woutput/regenboogpiano/Mechanica/Klavier/Grove layout klavier.png

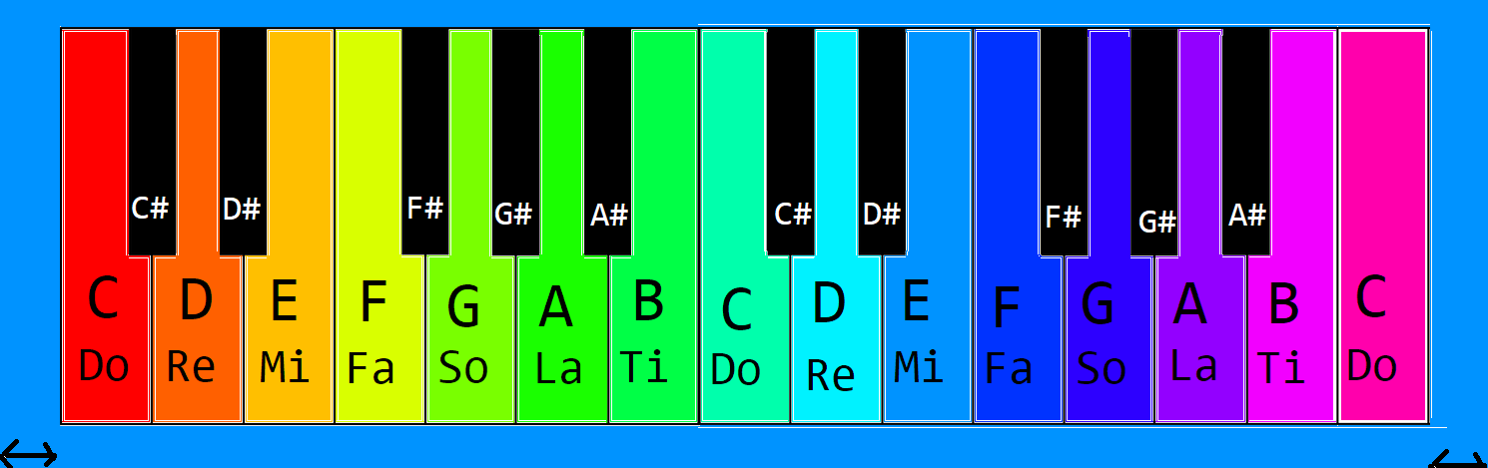
Mechanica/Klavier/Grove layout klavier.png
