woutput/regenboogpiano/Mechanica/Klavier/Klavier volgens boomwhackers.png

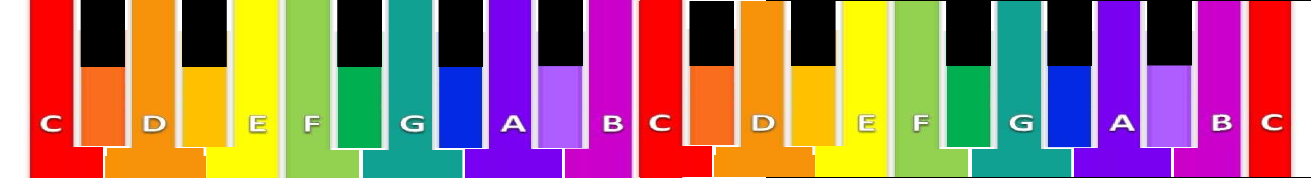
Mechanica/Klavier/Klavier volgens boomwhackers.png
