woutput/regenboogpiano/Oud/Elektronisch wandspeelbord - voorstel.docx

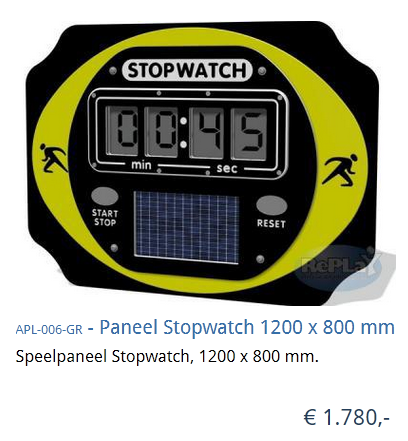
[picture p3: figure]
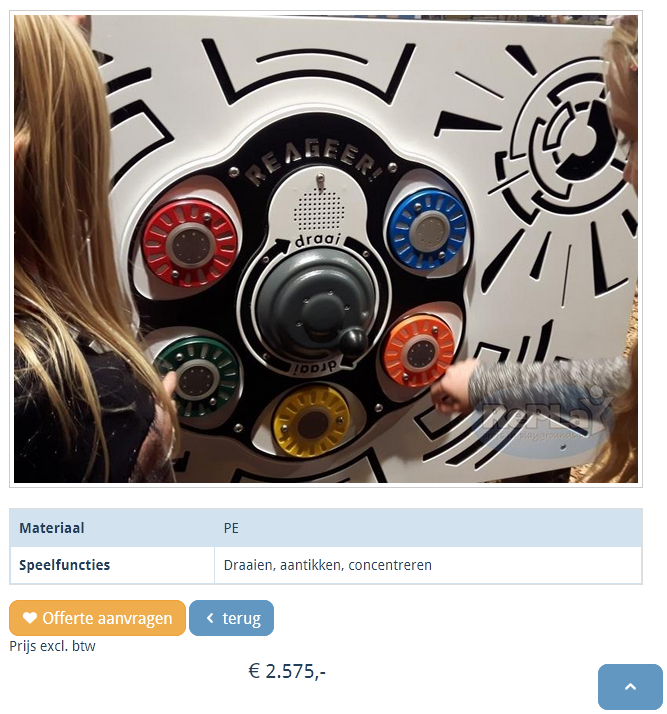
[picture p4: figure]

Bijvoorbeeld thema Regenboogschool

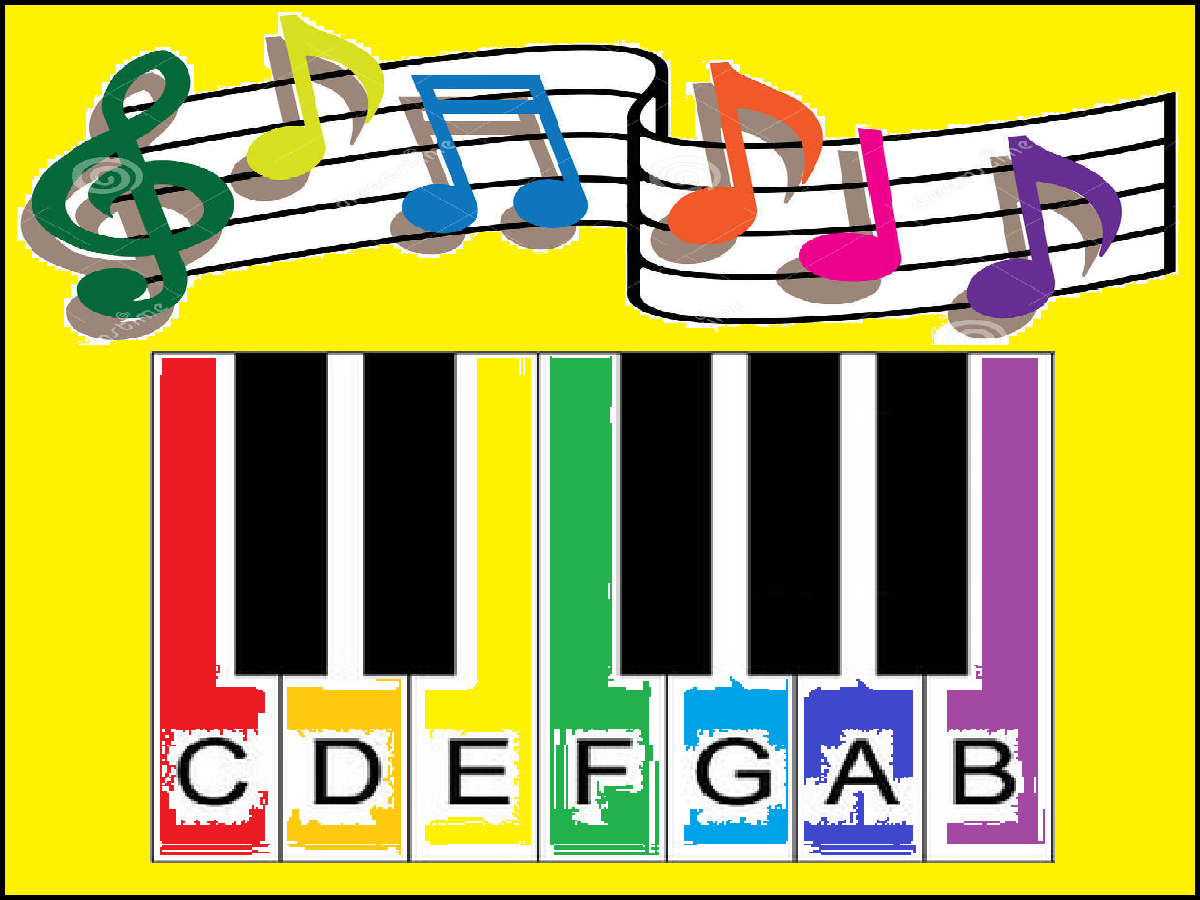
[picture p5: figure]

A. Kinderen spelen zelf op de piano
B. De lampjes laten de juiste volgorde zien, de kinderen spelen een liedje
C. Muziek speelt, de kinderen spelen mee op de piano (zoals Guitar Hero op PlayStation)
D. De computer speelt een liedje, begint met de eerste noot, steeds één noot langer, de kinderen spelen het zo lang mogelijk na (“Simon says”)
E. …

Veilig, robuust, onderhoudsvriendelijk, leerzaam, leuk, …

Schatting kosten

- Mechanica ~ €250
- Elektronica ~ €250
- Totaal ~ €500
