woutput/regenboogpiano/Elektronica/Facturen/E.pdf

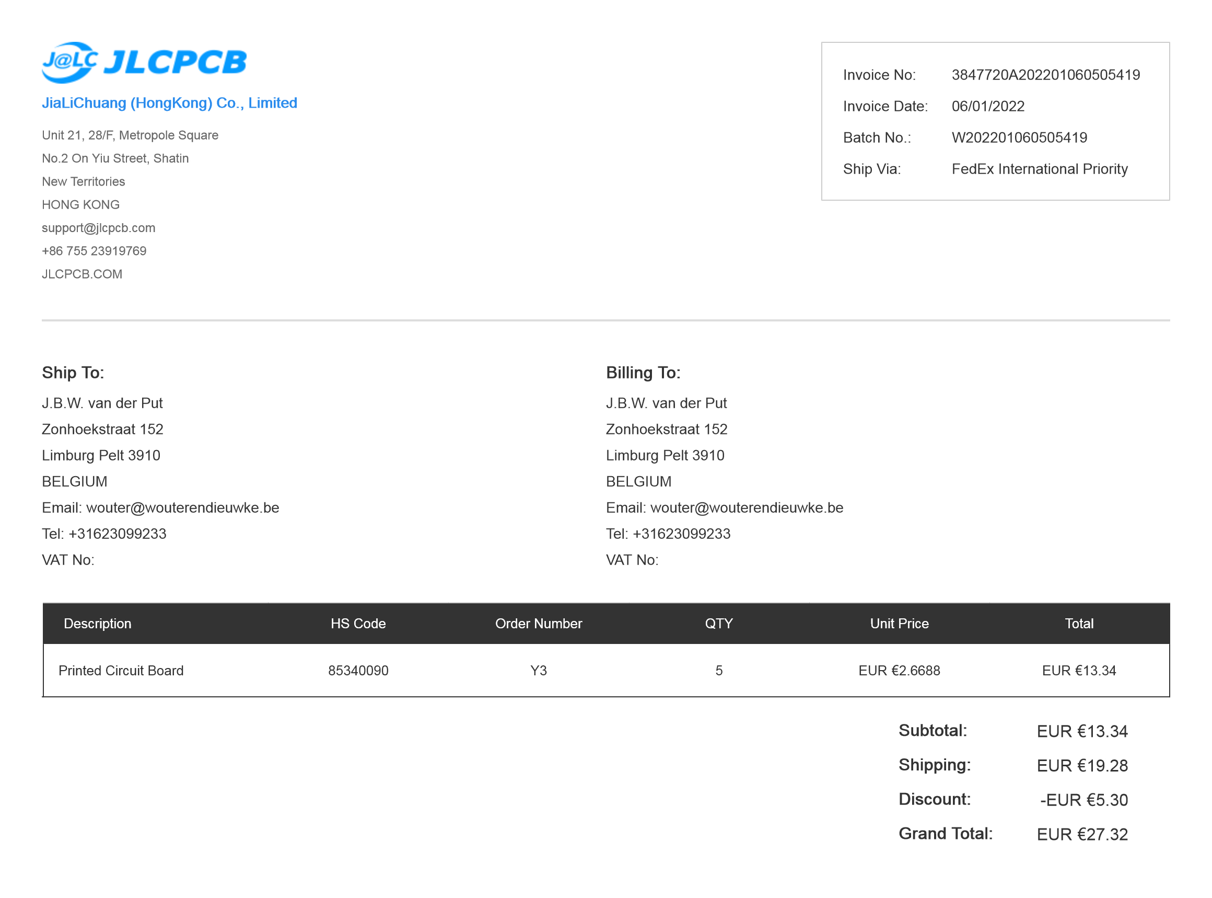
[picture p6: figure]
