woutput/regenboogpiano/Elektronica/Facturen/F.pdf

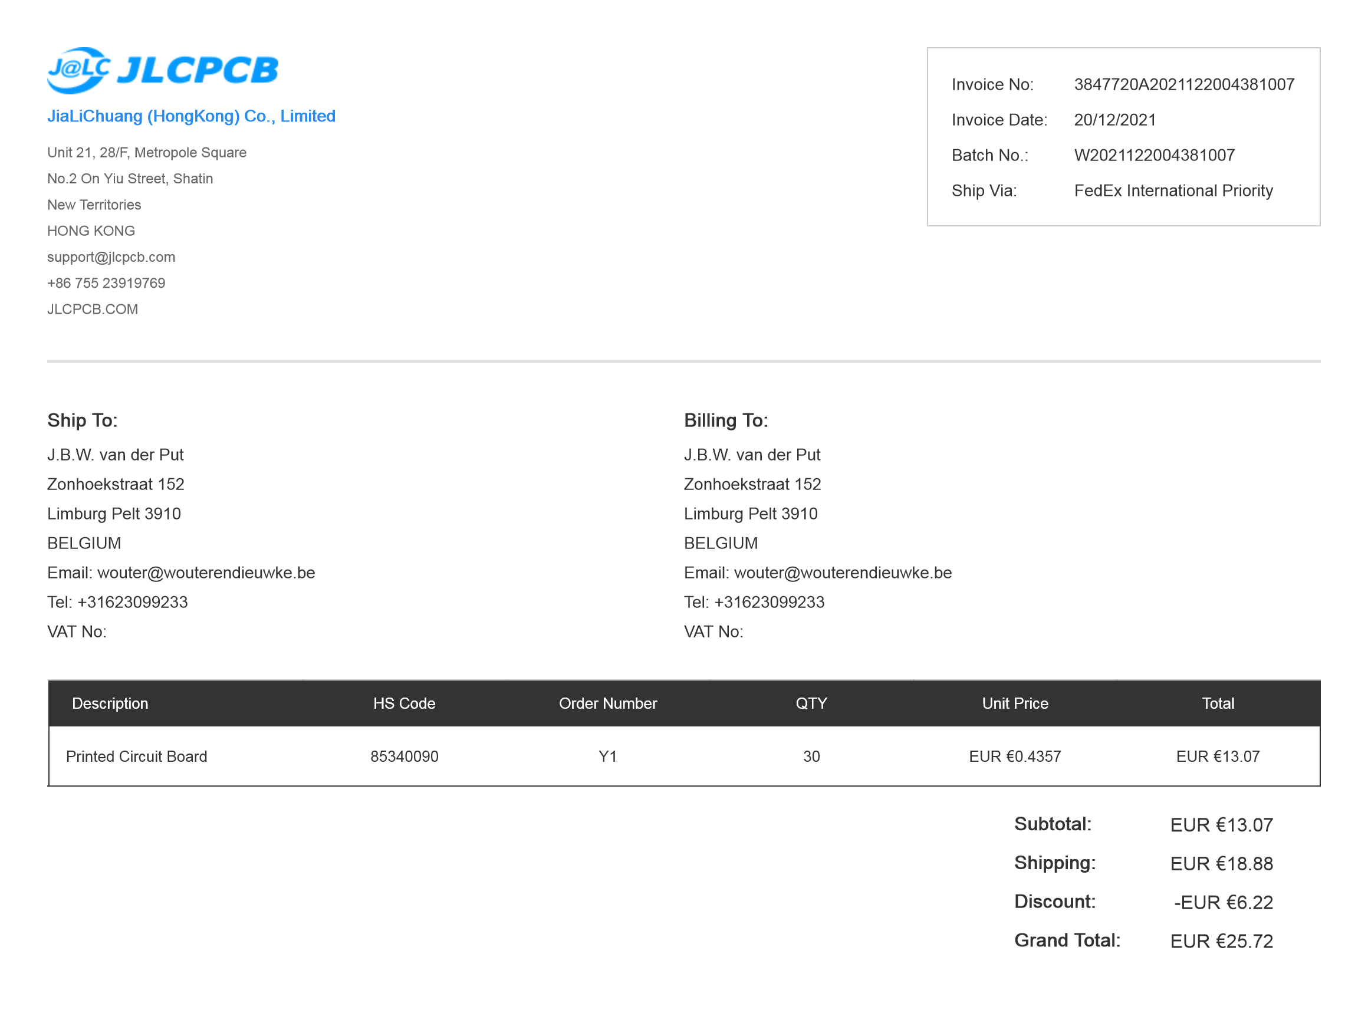
[picture p7: figure]
