woutput/regenboogpiano/Mechanica/Klavier/12 kleuren.xlsx

# | Hue | R | G | B | Noot | C[%] | M[%] | Y[%] | K[%] | Naam
0 | 0 | 255 | 0 | 0 | C | 0 | 100 | 100 | 0 | ROOD
1 | 14 | 255 | 61 | 0 | C# (zwart) | 0 | 76 | 100 | 0 | ROOD-ORANJE
2 | 28 | 255 | 120 | 0 | D | 0 | 53 | 100 | 0 | ORANJE
3 | 44 | 255 | 186 | 0 | D# (zwart) | 0 | 27 | 100 | 0 | ORANJE-GEEL
4 | 60 | 255 | 255 | 0 | E | 0 | 0 | 100 | 0 | GEEL
5 | 90 | 128 | 255 | 0 | F | 50 | 0 | 100 | 0 | GEEL-GROEN
6 | 114 | 26 | 255 | 0 | F# (zwart) | 90 | 0 | 100 | 0 | GROEN
7 | 146 | 24 | 237 | 116 | G | 91 | 7 | 54 | 0 | GROEN-BLAUW
8 | 233 | 28 | 56 | 255 | G# (zwart) | 89 | 78 | 0 | 0 | BLAUW
9 | 251 | 84 | 46 | 255 | A | 67 | 82 | 0 | 0 | BLAUWPAARS
10 | 260 | 130 | 69 | 255 | A# (zwart) | 49 | 73 | 0 | 0 | PAARS
11 | 280 | 179 | 23 | 255 | B | 30 | 91 | 0 | 0 | PAARSROOD
