woutput/regenboogpiano/Mechanica/Klavier/cmyk.xlsx

 | ROOD | ROOD-ORANJE | ORANJE | ORANJE-GEEL | GEEL | GEEL-GROEN | GROEN | GROEN-BLAUW | BLAUW | BLAUWPAARS | PAARS | PAARSROOD
 | C | C# | D | D# | E | F | F# | G | G# | A | A# | B
C | 0 | 0 | 0 | 0 | 0 | 50 | 90 | 91 | 89 | 67 | 49 | 30
M | 100 | 76 | 53 | 27 | 0 | 0 | 0 | 7 | 78 | 82 | 73 | 91
Y | 100 | 100 | 100 | 100 | 100 | 100 | 100 | 54 | 0 | 0 | 0 | 0
K | 0 | 0 | 0 | 0 | 0 | 0 | 0 | 0 | 0 | 0 | 0 | 0
