woutput/regenboogpiano/Detail toets.png

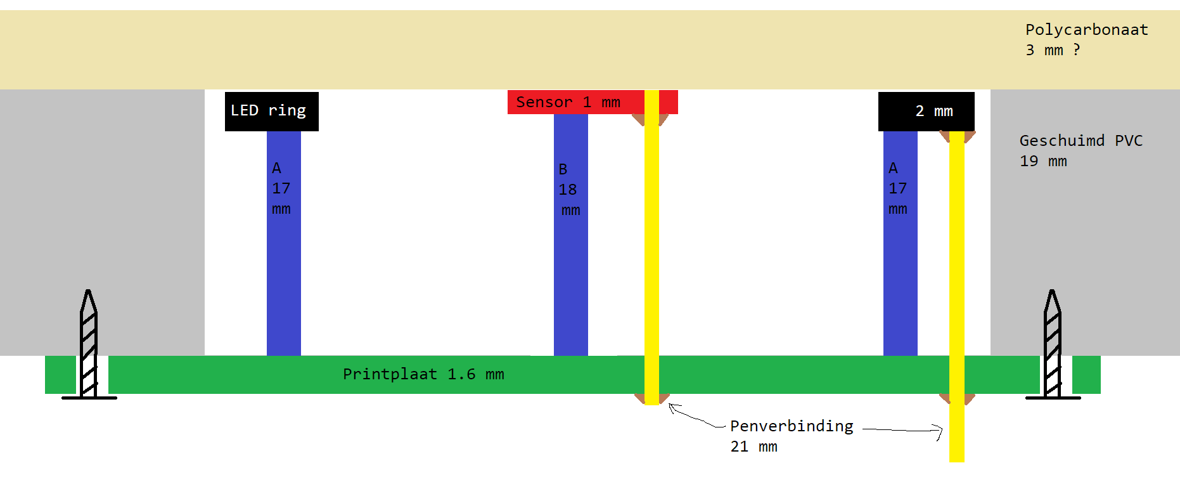
Detail toets.png
