woutput/regenboogpiano/Elektronica/KiCad projecten/Toetsmodule/Schema.png

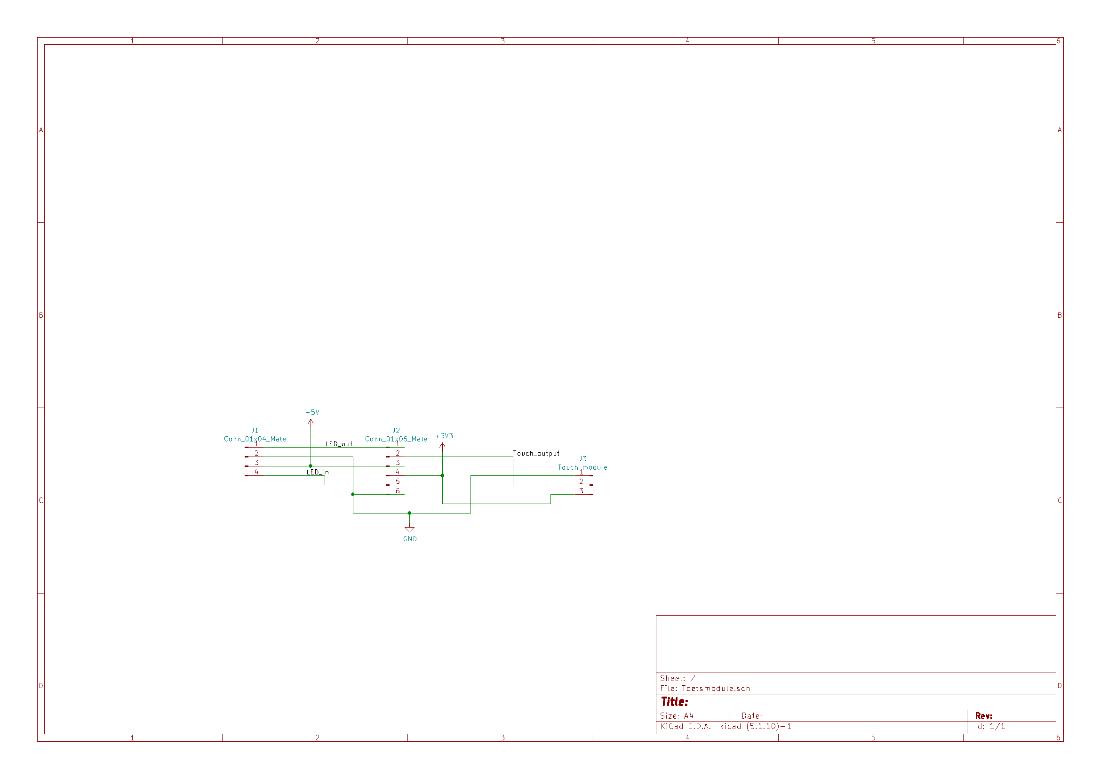
Elektronica/KiCad projecten/Toetsmodule/Schema.png
