woutput/regenboogpiano/Elektronica/Overzicht elektrisch schema.png

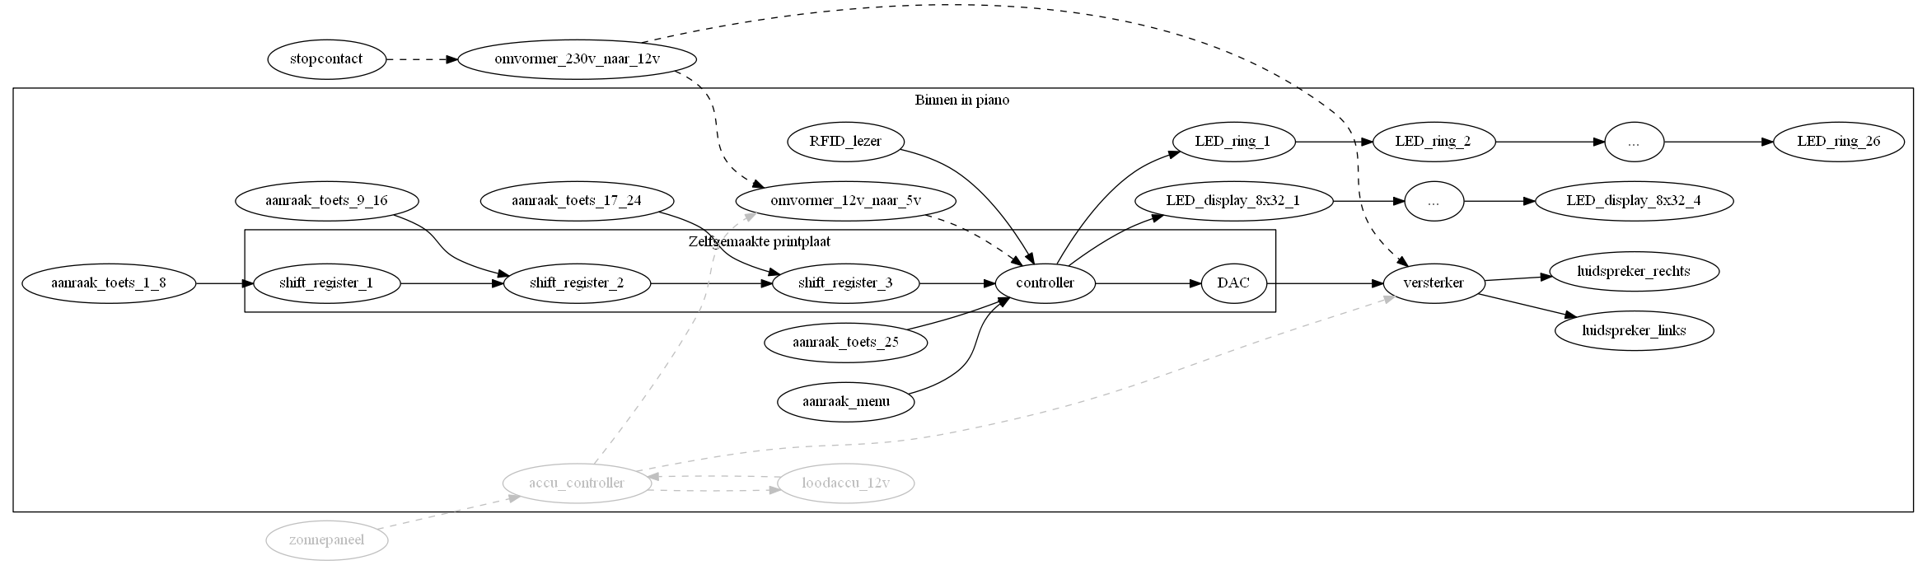
Elektronica/Overzicht elektrisch schema.png
