woutput/regenboogpiano/Mechanica/3D-model/Regenboogpiano.png

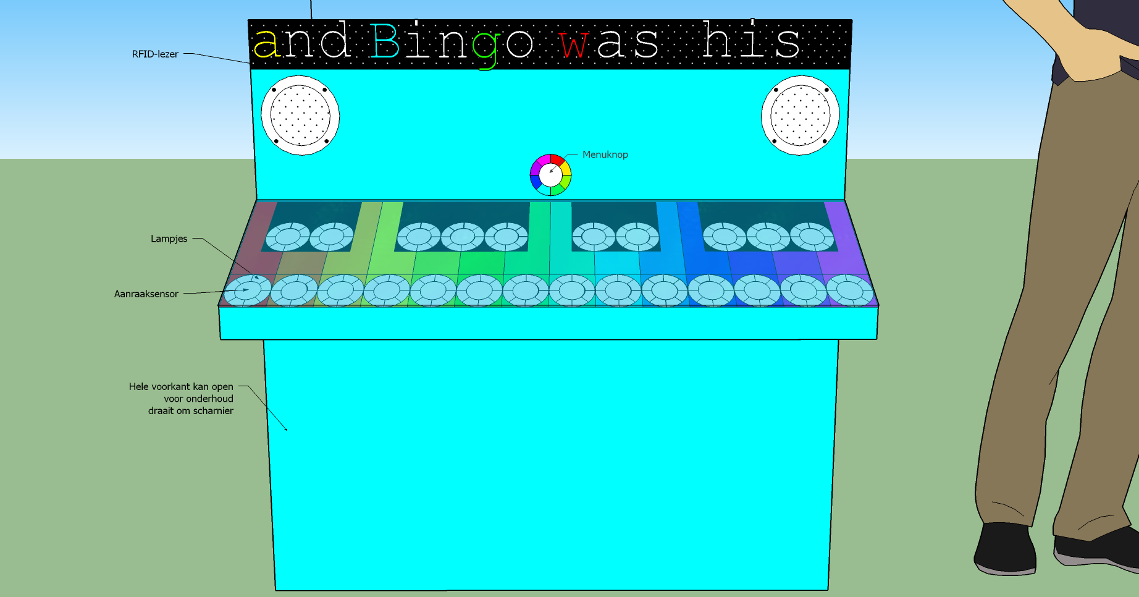
Mechanica/3D-model/Regenboogpiano.png
