woutput/regenboogpiano/Mechanica/Klavier/index.jpg

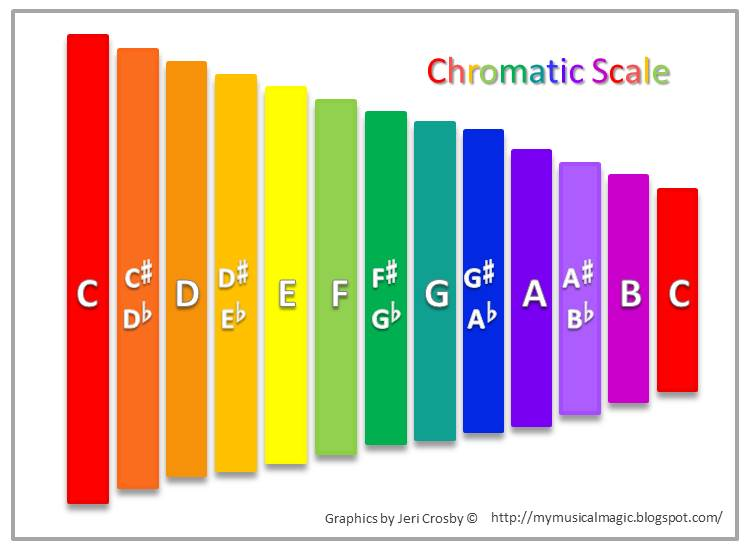
Mechanica/Klavier/index.jpg
