woutput/regenboogpiano/Mechanica/Klavier/Klavier detail.png

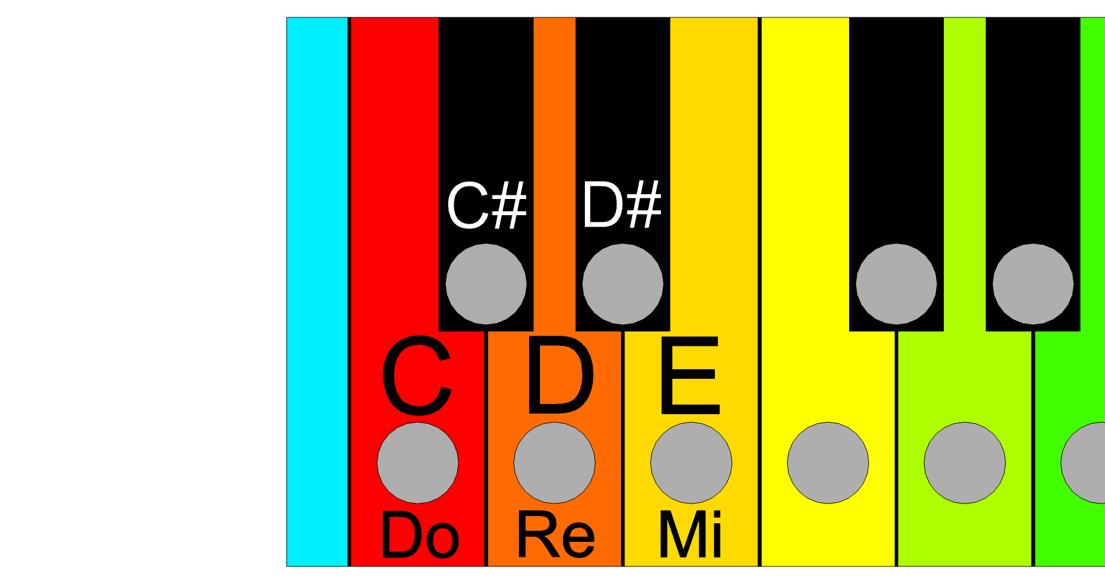
Mechanica/Klavier/Klavier detail.png
