woutput/regenboogpiano/Mechanica/Klavier/Klavier helemaal.png

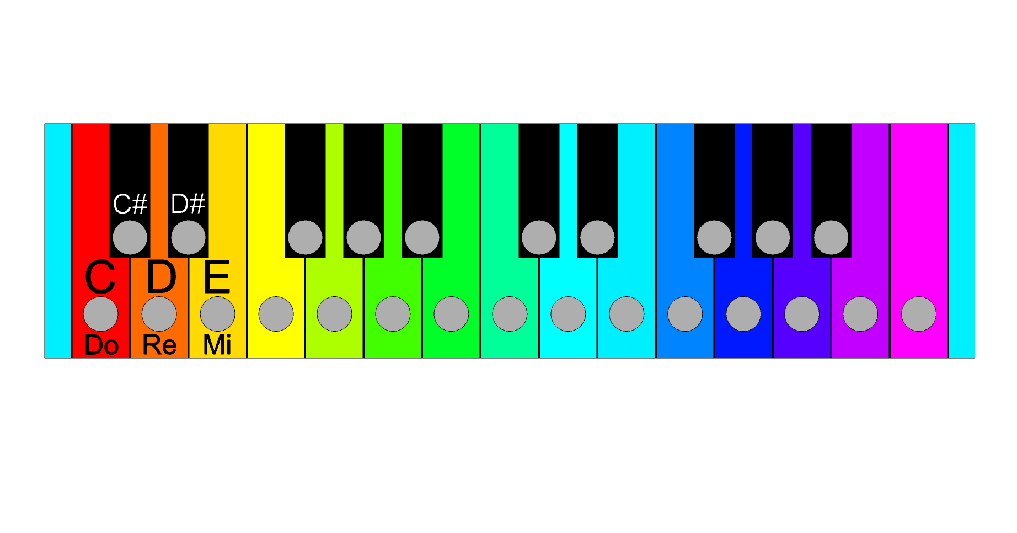
Mechanica/Klavier/Klavier helemaal.png
