woutput/regenboogpiano/Mechanica/Klavier/Kleuren vs boomwhackers.png

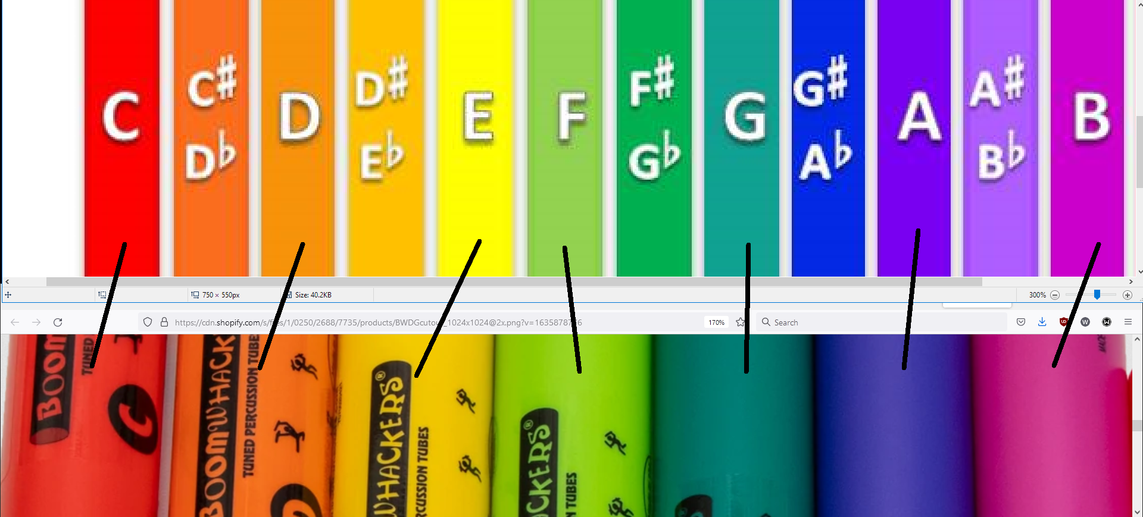
Mechanica/Klavier/Kleuren vs boomwhackers.png
