woutput/regenboogpiano/Oud/Kinderen opmeten/Grond - Hoofd.png

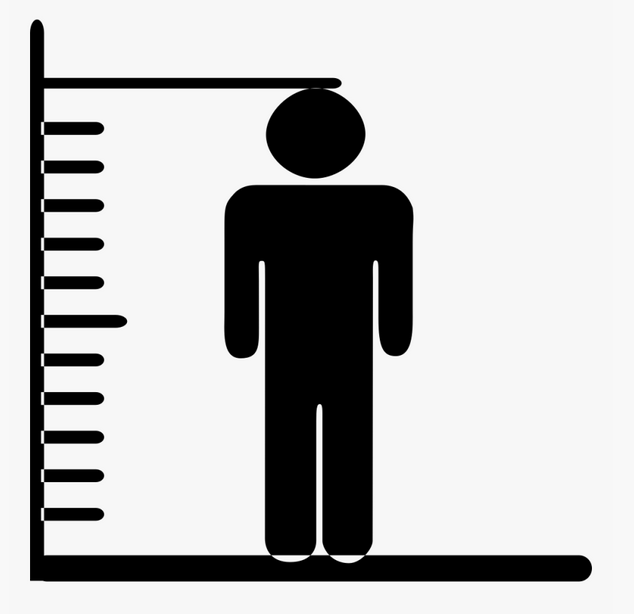
Oud/Kinderen opmeten/Grond - Hoofd.png
