woutput/regenboogpiano/Oud/Kinderen opmeten/Puntje middelvinger links - Puntje middelvinger rechts.png

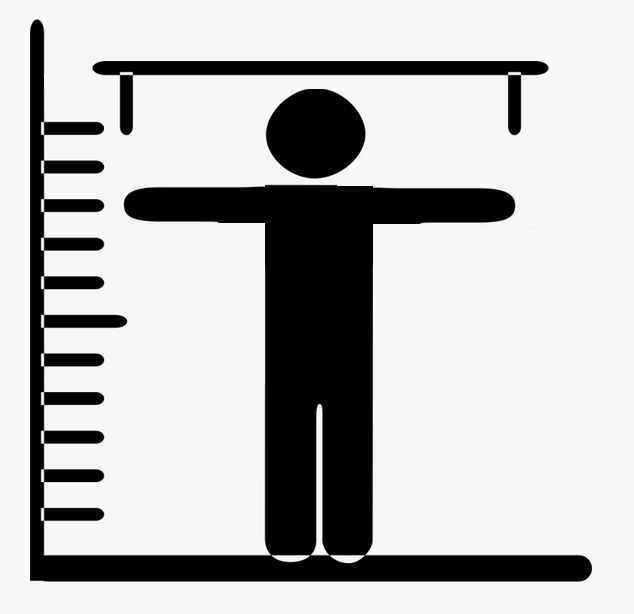
Oud/Kinderen opmeten/Puntje middelvinger links - Puntje middelvinger rechts.png
