woutput/regenboogpiano/Oud/Vergelijking afmetingen.png

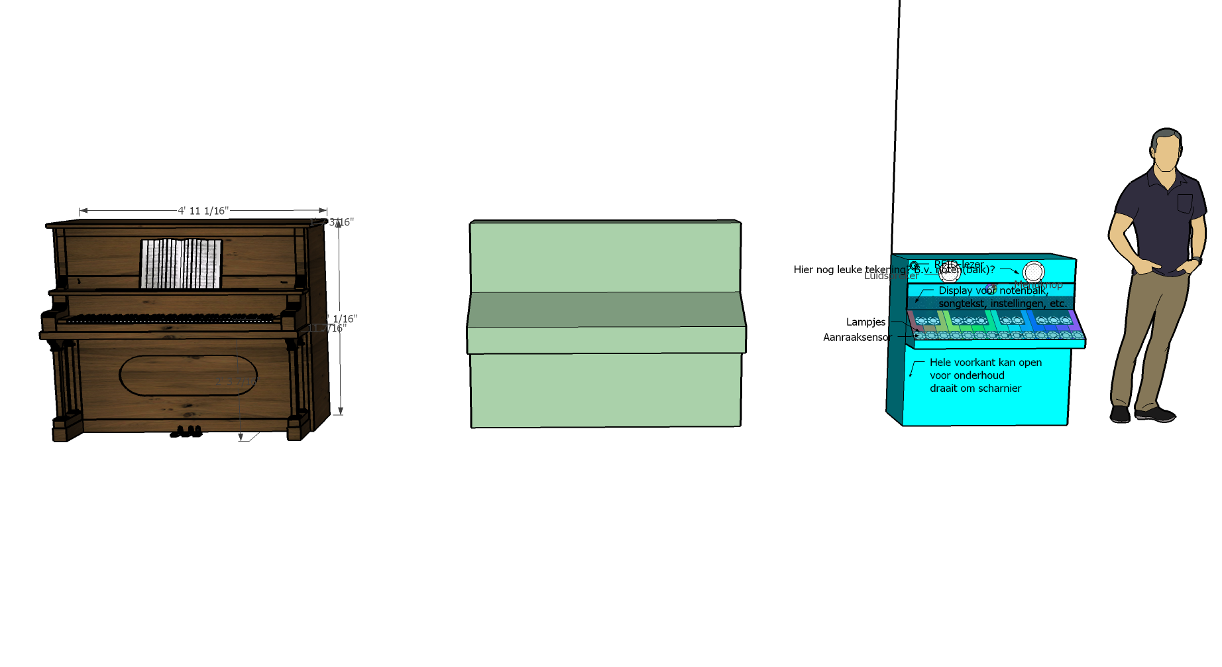
Oud/Vergelijking afmetingen.png
