woutput/regenboogpiano/Oud/Verhoudingen.png

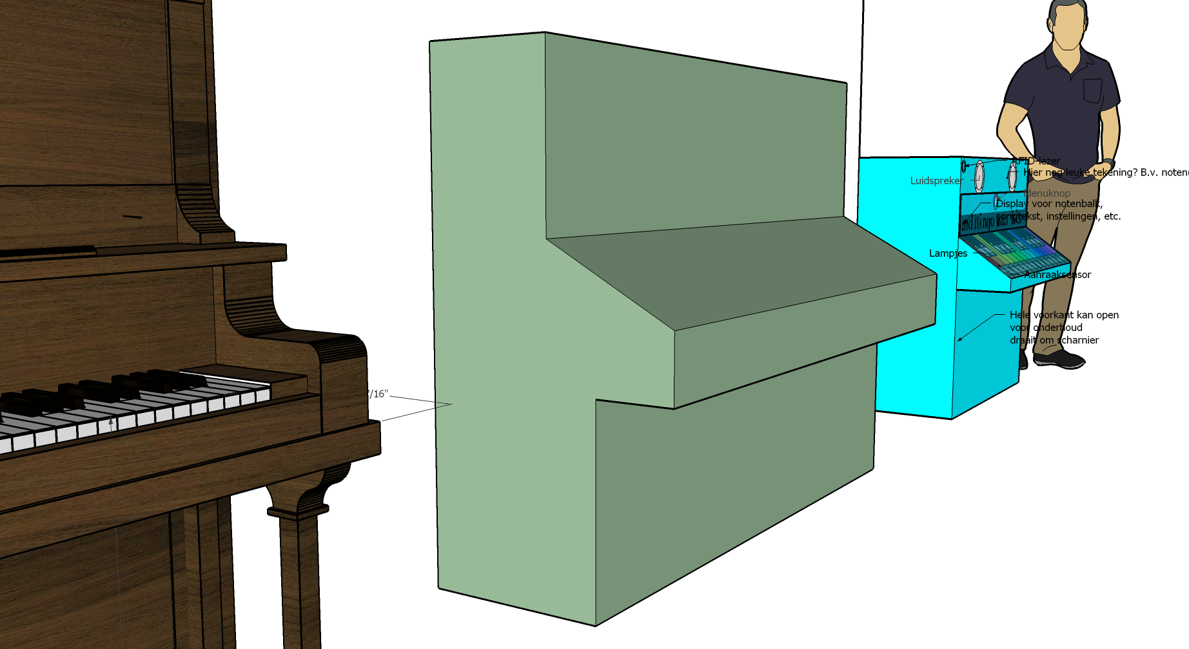
Oud/Verhoudingen.png
