woutput/regenboogpiano/Welke noten in het klavier.png

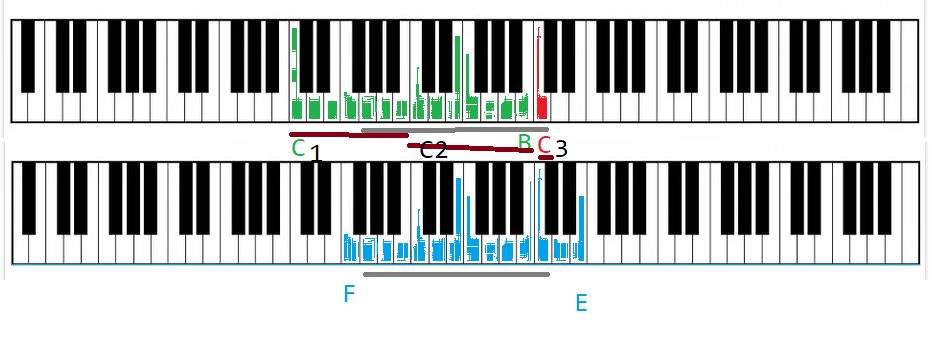
Welke noten in het klavier.png
