woutput/regenboogpiano/Onderdelen en kosten.xlsx

Aantal | Beschrijving | Winkel | Prijs per stuk | Subtotaal | Factuur | Gekocht | Betaald | Reserve | Opmerking
25 | LED-ring, 12 LEDs | Amazon | €4.00 | €100.00 | A | 30 | €59.94 | 5
 | LED-ring, 12 LEDs | AliExpress |  |  | B | 5 | €7.27 | 5
1 | Zonnepaneel 18 V, 30 W + controller 12 V, 10 A? | AliExpress | €45.00 | €45.00 |  | 0 | €0.00 | 0 | Voor de toekomst?
3 | LED-display 8x32 | AliExpress | €14.00 | €42.00 | C | 3 | €31.70 | 0
 | LED-display 8x32 | AliExpress |  |  | D | 3 | €31.73 | 2
1 | Zelfgemaakte printplaat moederbord | JLCPCB | €40.00 | €40.00 | E | 5 | €27.69 | 4 | Prijs inclusief wisselkosten
0 | Zelfgemaakte printplaat toetsmodule | JLCPCB | €0.00 | €0.00 | F | 30 | €25.94 | 5 | Prijs inclusief wisselkosten
1 | microSD, industr., SLC, 8 GB | RS-online | €35.00 | €35.00 |  | 0 | €0.00 | 0 | Niet nodig
1 | Loodaccu 12V, AGM, 12 Ah | NKON | €30.00 | €30.00 |  | 0 | €0.00 | 0 | Voor de toekomst?
0 | Voeding 12 V, 100 W | Tinytronics | €0.00 | €0.00 | G | 2 | €44.48 | 1 | In plaats van zonnepaneel/accu
1 | Omvormer 12V>5V, 20A | AliExpress | €30.00 | €30.00 | H | 2 | €34.48 | 1
2 | Luidspreker, waterproof | AliExpress | €12.50 | €25.00 | I | 2 | €17.75 | 0
 | Luidspreker, waterproof | AliExpress |  |  | J | 1 | €9.73 | 1
1 | Bedrading, connectors, e.d. | AliExpress | €25.00 | €25.00 | K |  | €8.63 |  | PCB terminal blocks
 | Bedrading, connectors, e.d. | Reichelt |  |  | L |  | €25.71 |  | Zekeringen, zekeringhouders en bezuining voor voeding
 | Bedrading, connectors, e.d. | AliExpress |  |  | R |  | €2.60 |  | Lange pinnen 2.54 mm
 | Bedrading, connectors, e.d. | AliExpress |  |  | S |  | €28.13 |  | Bandkabel, kabelconnectors en PCB-connectors
 | Bedrading, connectors, e.d. | allekabels.nl |  |  | V | 2 | €22.93 |  | Plastic-spray
1 | Controller, ESP32, T-Display | AliExpress | €15.00 | €15.00 | M | 1 | €13.16 | 0
 | Controller, ESP32, T-Display | Tinytronics |  |  | T | 1 | €13.48 | 1
1 | Versterker (klasse D) | Tinytronics | €9.00 | €9.00 | G | 2 | €22.48 | 1
25 | Aanraaksensor | AliExpress | €0.30 | €7.50 | N | 50 | €4.92 | 25
2 | DAC | AliExpress | €2.50 | €5.00 | O | 1 | €14.52 | 0 | Losse DAC is ondertussen veel duurder geworden
 | DAC | AliExpress |  |  | U | 1 | €3.48 | 1
1 | RFID-lezer | AliExpress | €3.00 | €3.00 | P | 2 | €2.78 | 1
1 | MicroSD card expansion board | AliExpress | €2.00 | €2.00 |  | 0 | €0.00 | 0 | Niet nodig
3 | Shift register 74HC165 of 74HC166 | AliExpress | €0.50 | €1.50 | Q | 5 | €5.58 | 2
1 | Onvoorzien 10% | ? | €41.50 | €41.50 |  | 0 | €0.00
 | Totaal elektronica |  |  | €456.50 |  |  | €459.10
2 | Geschuimd PVC, 10/19 mm [m2] | Zwartopwit | €90.00 | €180.00 |  |  | €650.00 |  | Geschuimd PVC i.p.v. Trespa
20 | Frame [m] | Walth? | €10.00 | €200.00 |  |  | €0.00 |  | Staal i.p.v. Hout
5 | Volkern/Trespa | Kunststofplaten | €60.00 | €300.00 |  | 0 | €0.00 |  | Geschuimd PVC i.p.v. Trespa
1 | Polycarbonaat, 3 mm [m2] | Kunststofplaten | €76.00 | €76.00 |  | 0 | €0.00
1 | IJzerwaren | ? | €50.00 | €50.00
1 | Onvoorzien 10% | ? | €80.60 | €80.60 |  |  |  |  | Wielen
 | Totaal mechanica |  |  | €886.60 |  |  | €650.00
 | Totaal |  | Begroot 10 nov | €1343.10 |  |  | €1109.10 |  | Werkelijk uitgegeven
