woutput/regenboogpiano/Oud/Kunststof.xlsx

Materiaal | Kleuren | Dikte [mm] | X [mm] | Y [mm] | Opp. [m2] | Plaat | Verzenden | Totaal/m2 | Speciaal | Speciaal | URL
PVC-hardschuim | 7 | 3 | 1000 | 1000 | 1.00 | €21.00 | €7.95 | €28.95 |  |  | Link (https://www.hornbach.nl/shop/GUTTAGLIss-Hobbycolor-kunststof-plaat-rood-500-x-250-x-3-0-mm/3887974/artikel.html)
Plexiglas | Rood/Groen/Blauw/Oranje/Wit/Grijs | 3 | 1000 | 1000 | 1.00 | €40.00 | €4.95 | €44.95 | Ophalen/bezorgen NL | Lichtdoorlatend | Link (https://www.hornbach.nl/shop/GUTTAGLIss-Acrylglas-Acrylcolor-glad-rood-250-x-500-x-3-0-mm/8055672/artikel.html)
Plexiglas | Rood/Groen/Blauw/Geel/Wit/Zwart | 3 | 1000 | 1000 | 1.00 | €63.55 | €42.29 | €105.8395 | Op maat meerkost |  | Link (https://kunststofplaten.be/product/opaalrood-plexiglas-3-mm/)
Plexiglas | Veel kleuren | 8 | 1000 | 1000 | 1.00 |  |  | €181.38 | Op maat |  | Link
Plexiglas | 13 | 8 | 300 | 200 | 0.06 |  |  | €30.79 |  |  | Link (https://shop.letterplex.nl/contents/nl/p816.html)
Geschuimd PVC == Forex | Geprint op wit | 10 | 1000 | 1000 | 1.00 | €65.00 | €11.98 | €76.979 | Op maat |  | Link (https://www.zwartopwit.be/shop/borden-panelen/schuim-pvc-10-mm/rechte-hoeken/quality/schuim-pvc-10-mm-premium-recto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)
Schuim PS | Geprint op wit | 10 | 1000 | 1000 | 1.00 | €66.75 | €11.98 | €78.729 | Op maat |  | Link (https://www.zwartopwit.be/shop/borden-panelen/schuim-ps-10-mm/rechte-hoeken/quality/smart-x-10-mm-premium-recto)
Geschuimd PVC == Forex | 9 | 3 | 400 | 300 | 0.12 | €5.45 | €12.04 | €145.7041667 |  |  | Link (https://shop.letterplex.nl/contents/nl/p388.html)
HPL == Trespa | 15 | 6 | 1000 | 1000 | 1.00 | €92.65 | €48.39 | €141.0376 | Op maat |  | Link (https://kunststofplatenshop.nl/hpl-plaat/kleur-structuur/)
 |  |  |  |  | 0.00 |  |  | #DIV/0! |  |  | Link
 |  |  |  |  | 0.00 |  |  | #DIV/0! |  |  | Link
 |  |  |  |  | 0.00 |  |  | #DIV/0! |  |  | Link
 |  |  |  |  | 0.00 |  |  | #DIV/0! |  |  | Link
 |  |  |  |  | 0.00 |  |  | #DIV/0! |  |  | Link
 |  |  |  |  | 0.00 |  |  | #DIV/0! |  |  | Link
 |  |  |  |  | 0.00 |  |  | #DIV/0! |  |  | Link
 |  |  |  |  | 0.00 |  |  | #DIV/0! |  |  | Link
 |  |  |  |  | 0.00 |  |  | #DIV/0! |  |  | Link
