woutput/regenboogpiano/(list of files, cad)

Other CAD files:
Mechanica/3D-model/Regenboogpiano.skp
Mechanica/3D-model/piano.skp
Mechanica/3D-model/piano1.skp
Mechanica/Klavier/Klavier.skp
