woutput/regenboogpiano/Software/diagram.pdf

## REGENBOOGPIANO DIAGRAM

V. 2022-01-14

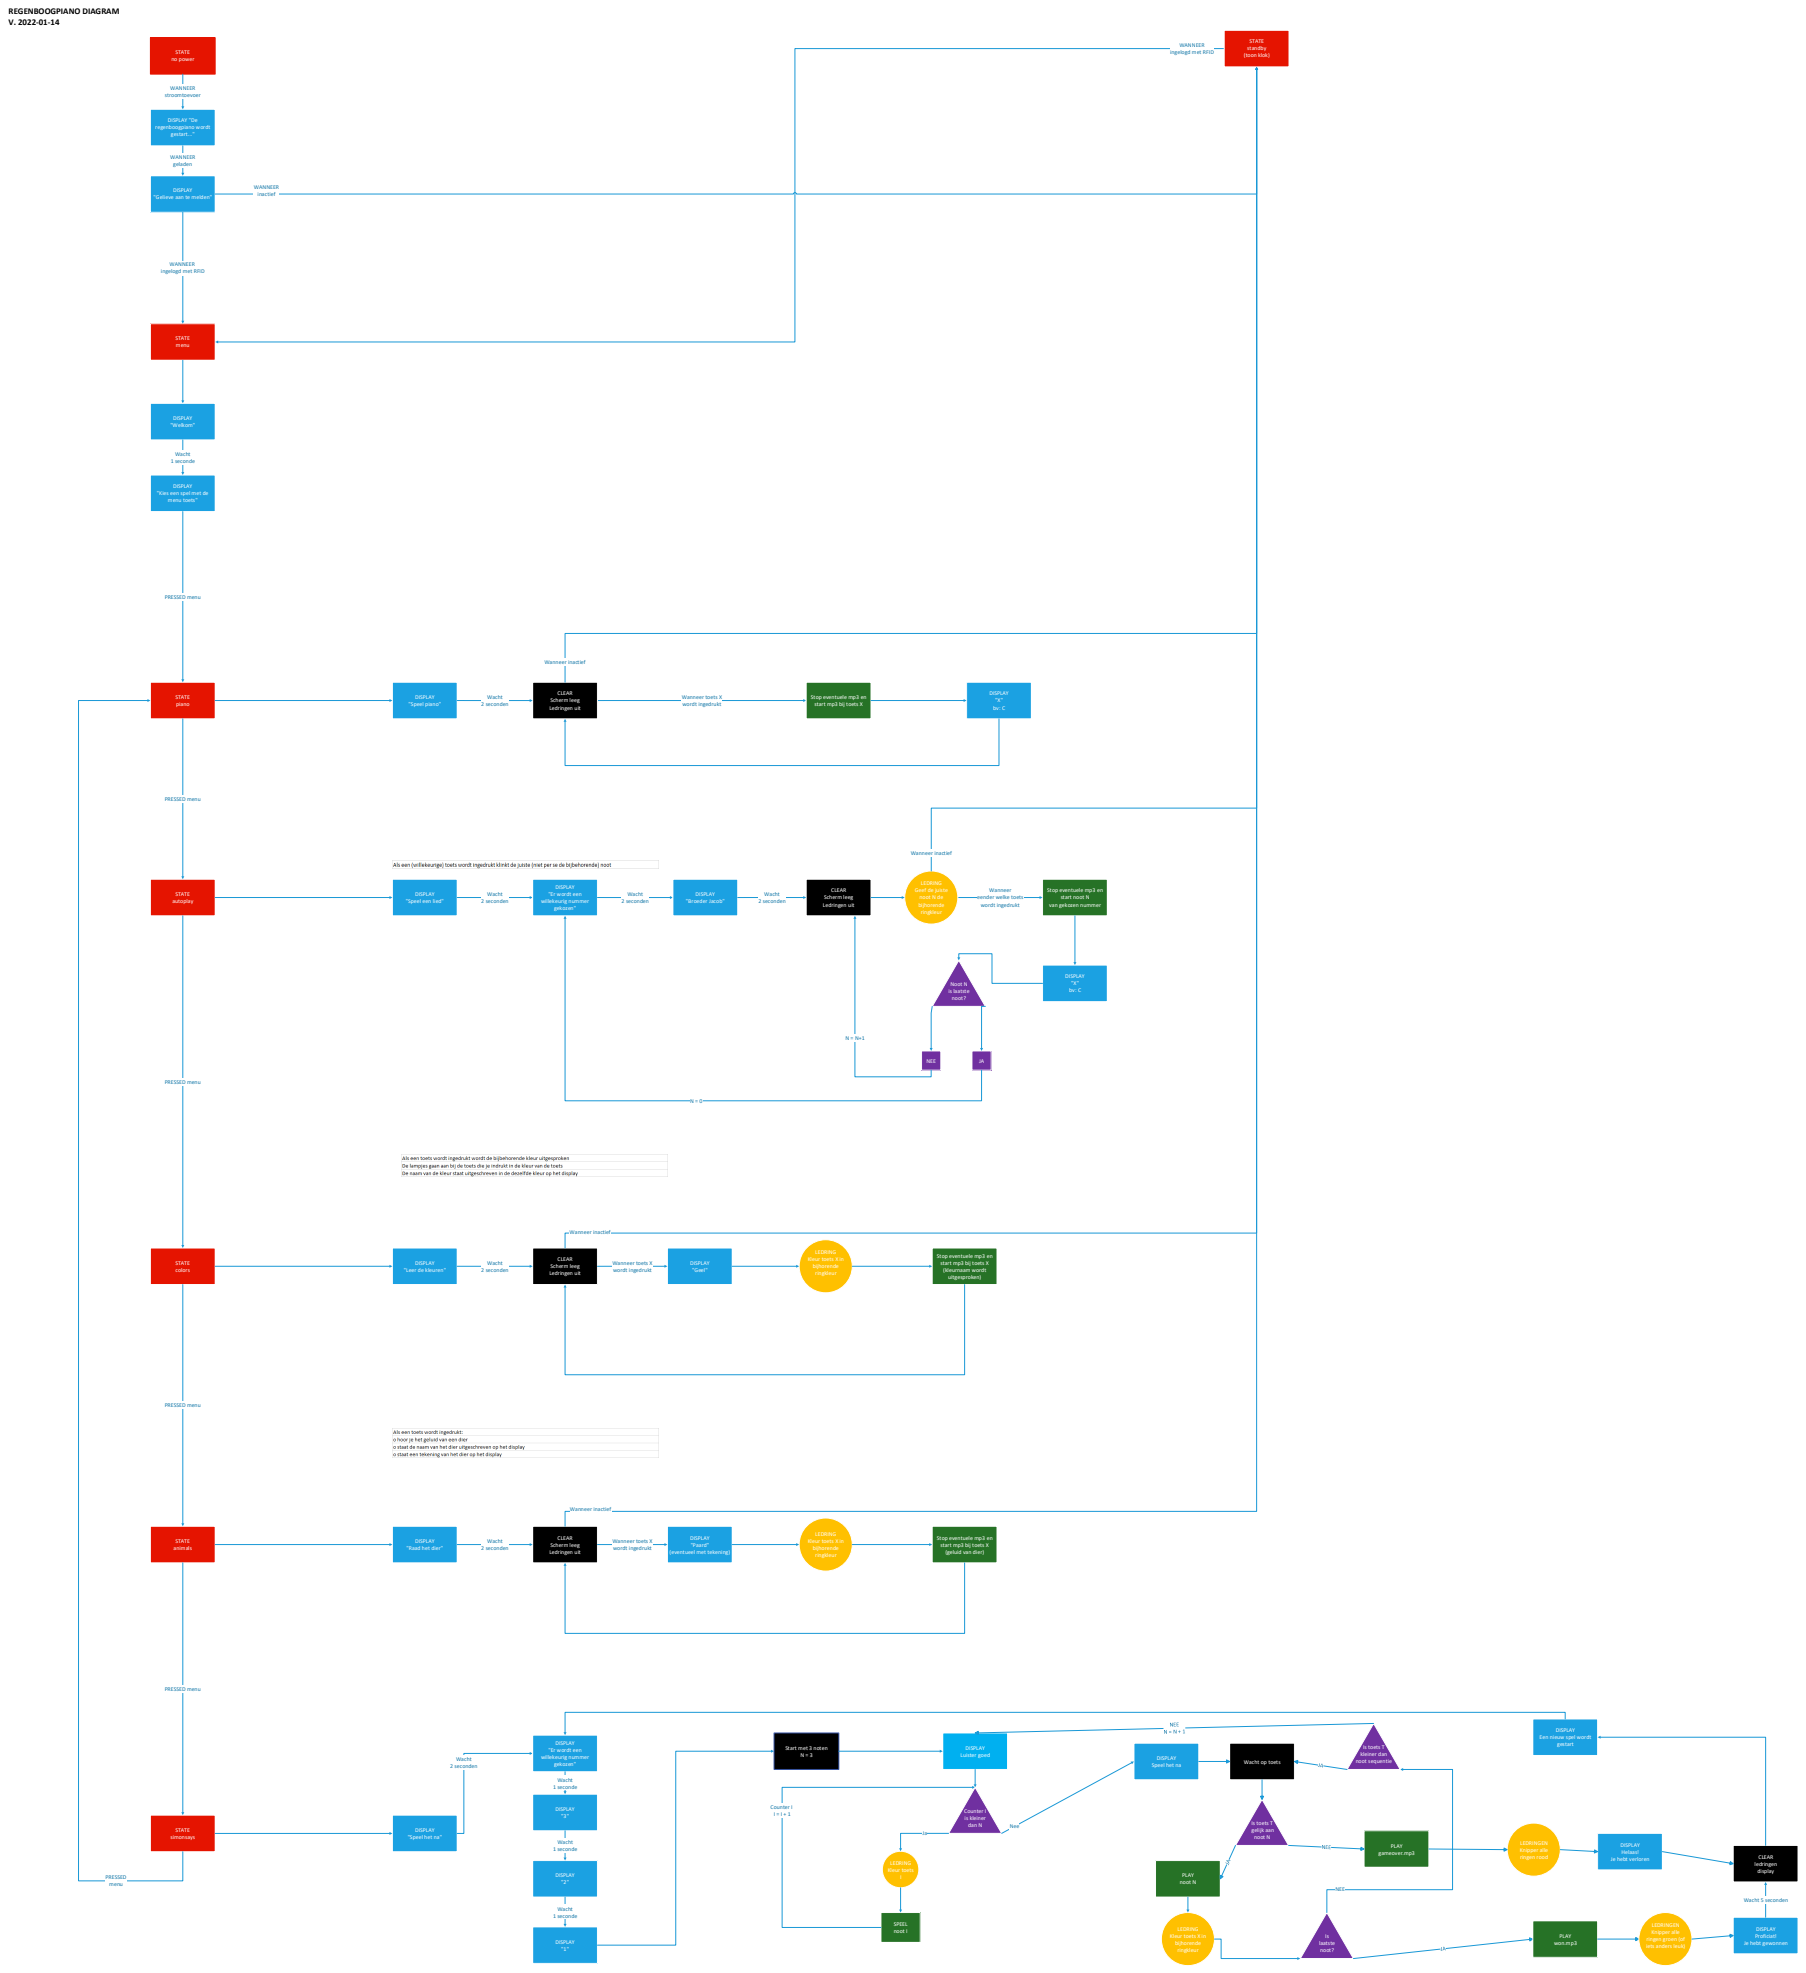
[picture p21: page 1]
STATE no power; DISPLAY; DISPLAY "De regenboogpiano wordt gestart..."; WANNEER stroomtoevoer; WANNEER geladen; WANNEER inactief; STATE menu; STATE standby (toon klok); DISPLAY "Speel piano"; STATE piano; PRESSED menu; STATE autoplay; STATE colors; STATE animals; STATE simonsays; Wanneer toets X wordt ingedrukt; CLEAR Scherm leeg Ledringen uit; Wacht 2 seconden; DISPLAY "X" bv: C; DISPLAY "Broeder Jacob"; Noot N is laatste noot?; NEE; DISPLAY "Geel"; DISPLAY "Paard"; DISPLAY "3"; DISPLAY "2"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

WANNEER
ingelogd met RFID

"Gelieve aan te melden"

DISPLAY
"Kies een spel met de
menu toets"

Stop eventuele mp3 en
start mp3 bij toets X

LEDRING
Geef de juiste
noot N de
bijhorende
ringkleur

"Er wordt een
willekeurig nummer
gekozen"

Wanneer
eender welke toets
wordt ingedrukt

start noot N
van gekozen nummer

"Speel een lied"

Kleur toets X in

(kleurnaam wordt
uitgesproken)

"Leer de kleuren"

(geluid van dier)

"Raad het dier"

(eventueel met tekening)

Een nieuw spel wordt
gestart

Start met 3 noten

Speel het na

Wacht op toets

"Speel het na"

Helaas!
Je hebt verloren

LEDRINGEN
Knipper alle
ringen groen (of
iets anders leuk)

Proficiat!
Je hebt gewonnen
