woutput/regenboogpiano/Mechanica/Bestelling PVC-schuim-platen/1. voetplaat.pdf

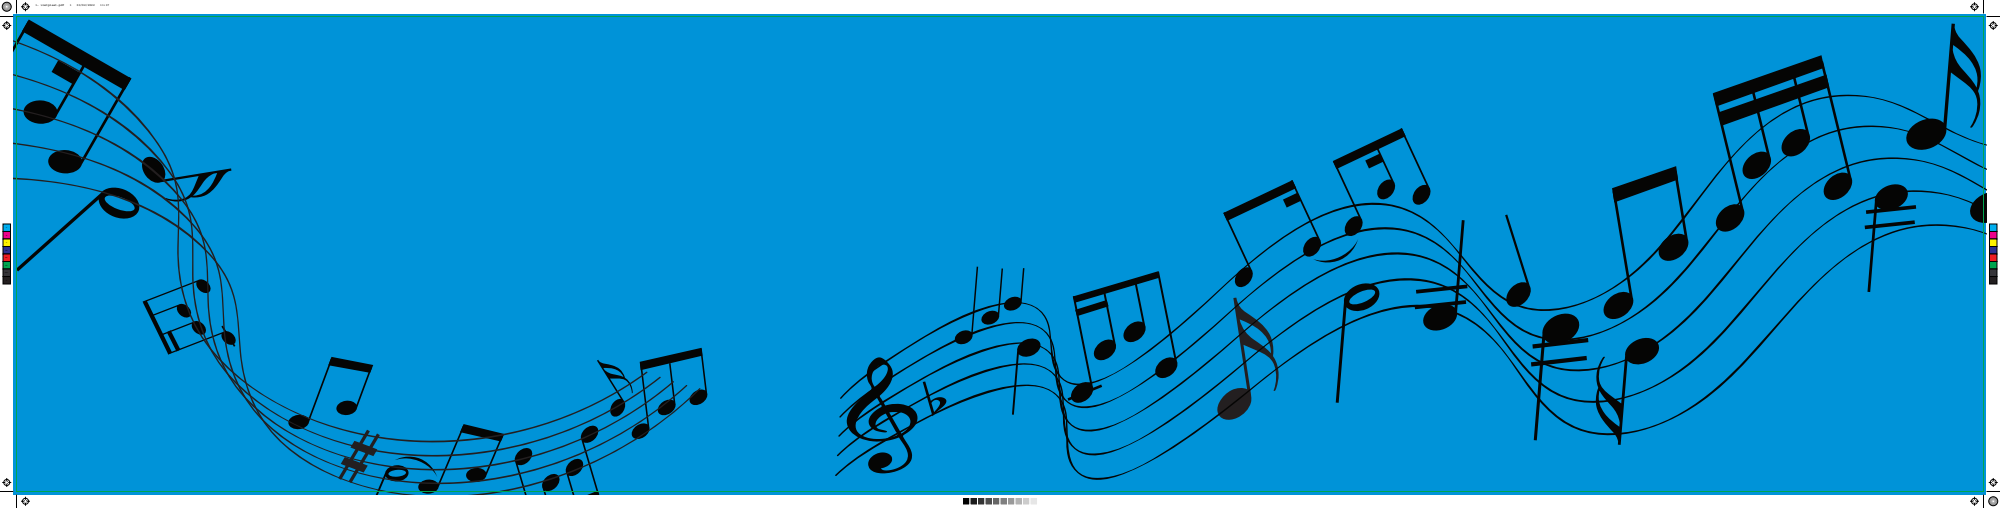
[picture p22: page 1]
CMY; 1. voetplaat.pdf
