woutput/regenboogpiano/Mechanica/Bestelling PVC-schuim-platen/2. onderplaat.pdf

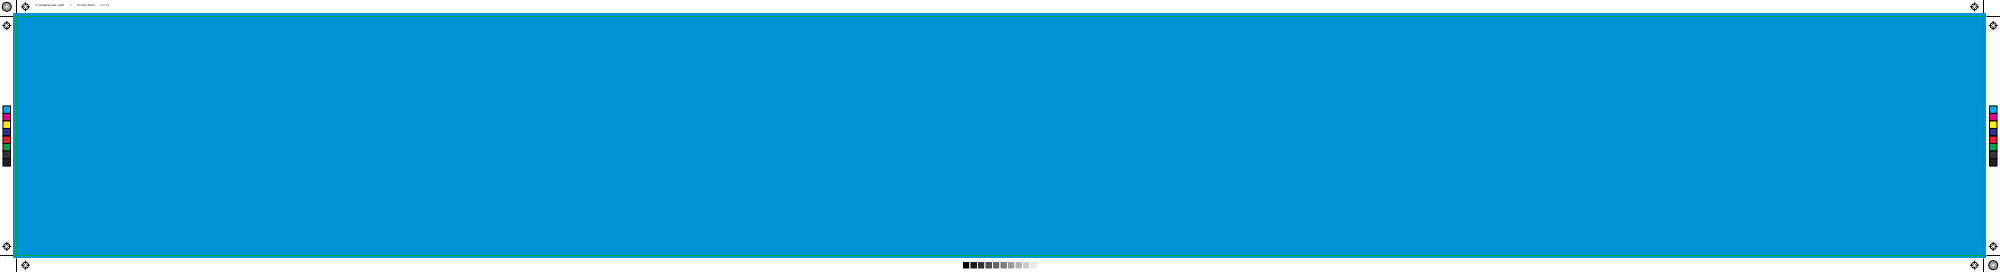
[picture p23: page 1]
CMY; 2.onderplaat.pdf
