woutput/regenboogpiano/Mechanica/Bestelling PVC-schuim-platen/3. voorplaat.pdf

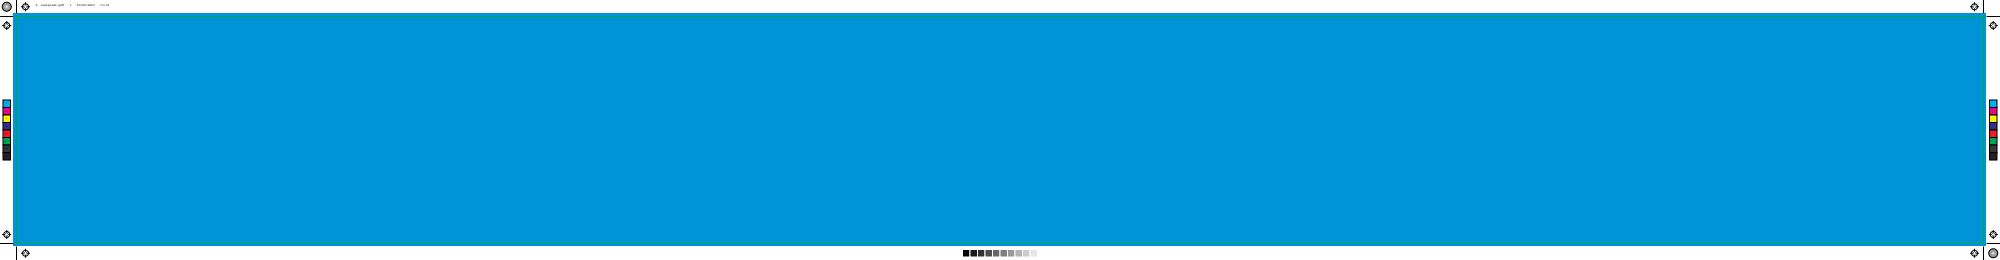
[picture p24: page 1]
CMY; 3. voorplaat.pdf
