woutput/regenboogpiano/Mechanica/Bestelling PVC-schuim-platen/4. plaat met gaten en bemating.pdf

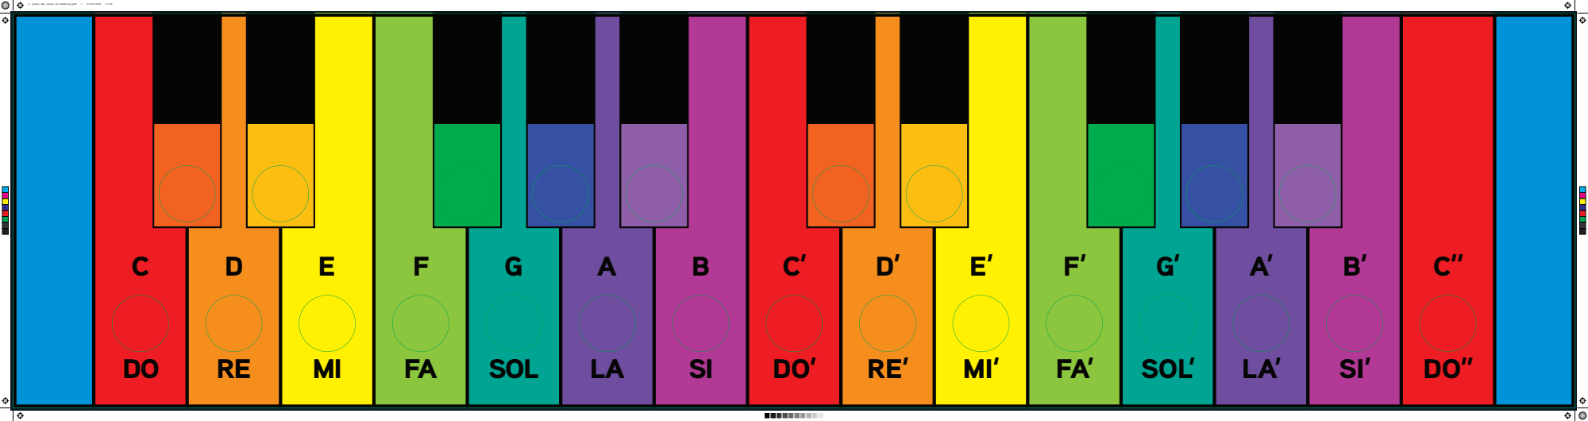
[picture p25: page 1]
SOL; SOL’; CMY; 4. plaat met gaten en bemating.pdf
