woutput/regenboogpiano/Mechanica/Bestelling PVC-schuim-platen/5. tekening voorplaat met boxen.pdf

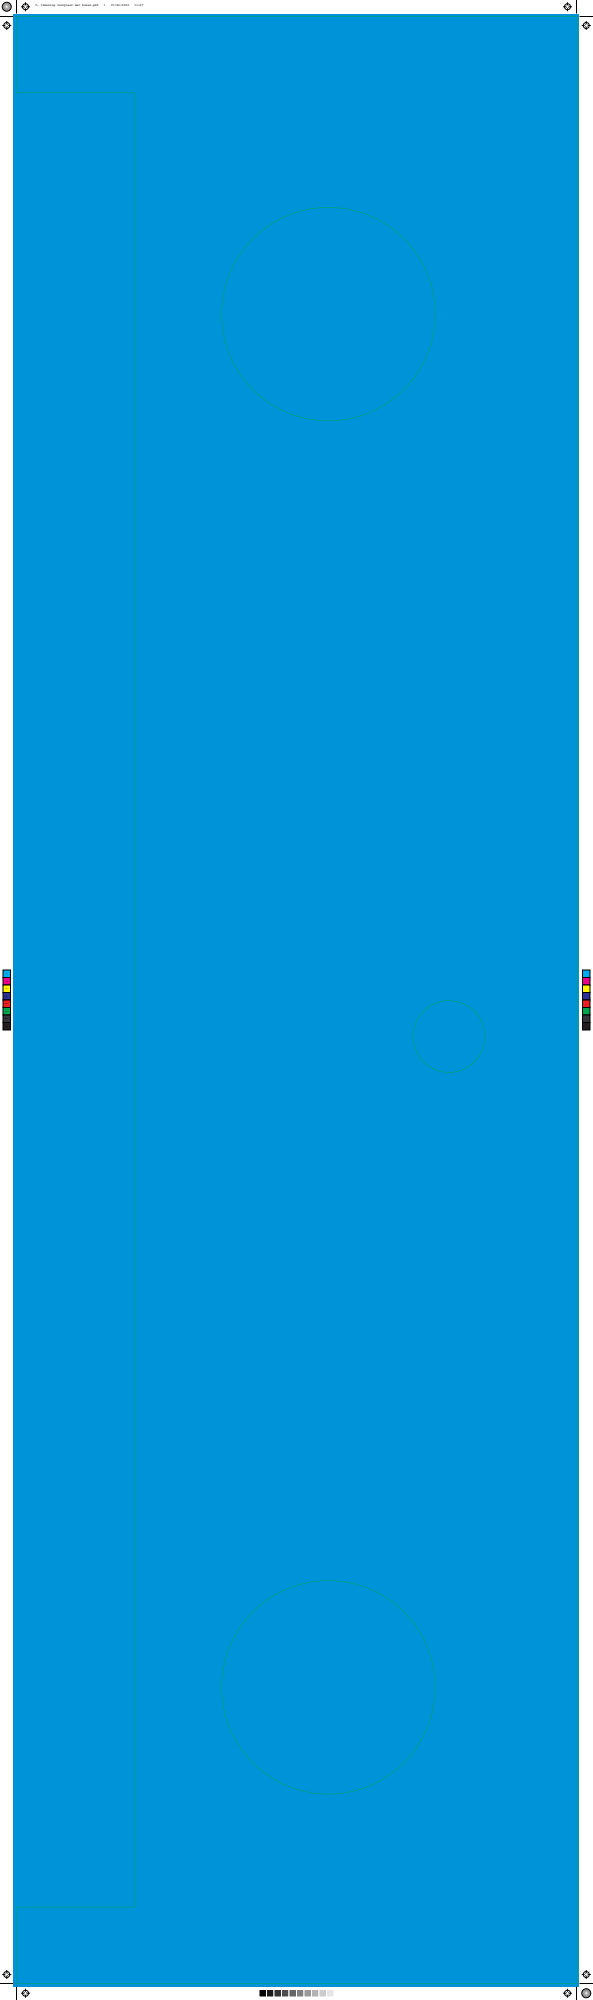
[picture p26: page 1]
CMY; 5. tekening voorplaat met boxen.pdf
