woutput/regenboogpiano/Mechanica/Bestelling PVC-schuim-platen/6. bovenplaat.pdf

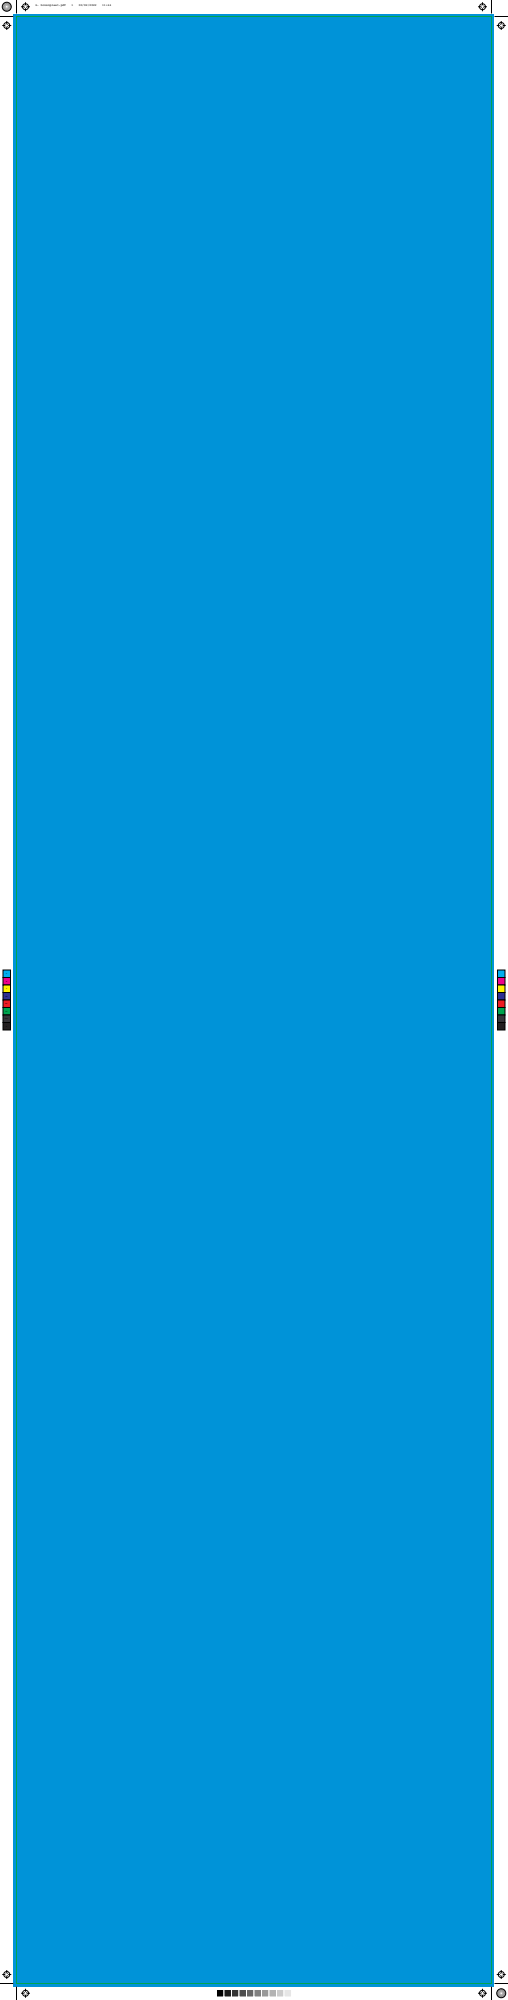
[picture p27: page 1]
CMY; 6. bovenplaat.pdf
