woutput/regenboogpiano/Mechanica/Bestelling PVC-schuim-platen/7. Zijkant_links.pdf

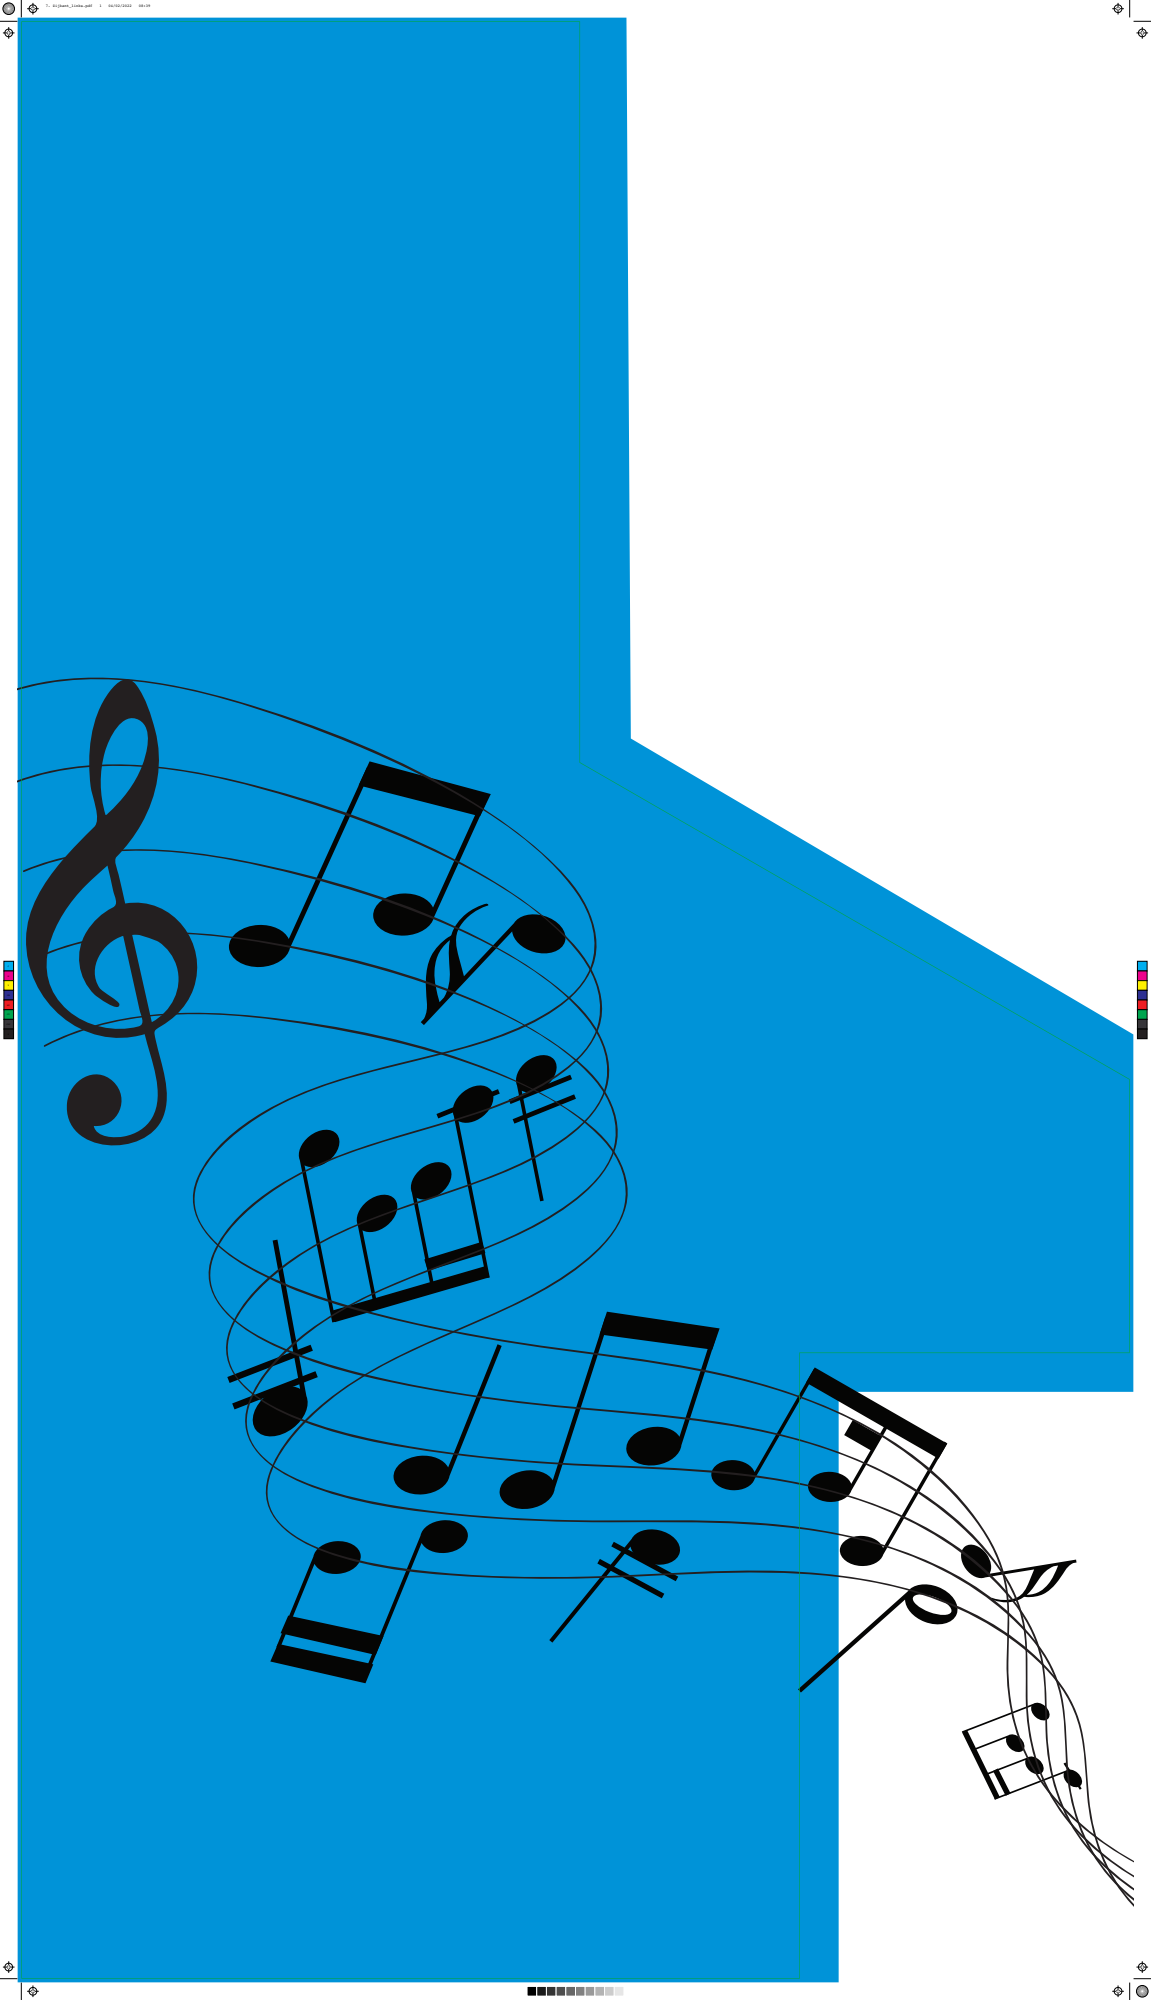
[picture p28: page 1]
CMY; 7. Zijkant_links.pdf
