woutput/regenboogpiano/Mechanica/Bestelling PVC-schuim-platen/8. Zijkant_rechts.pdf

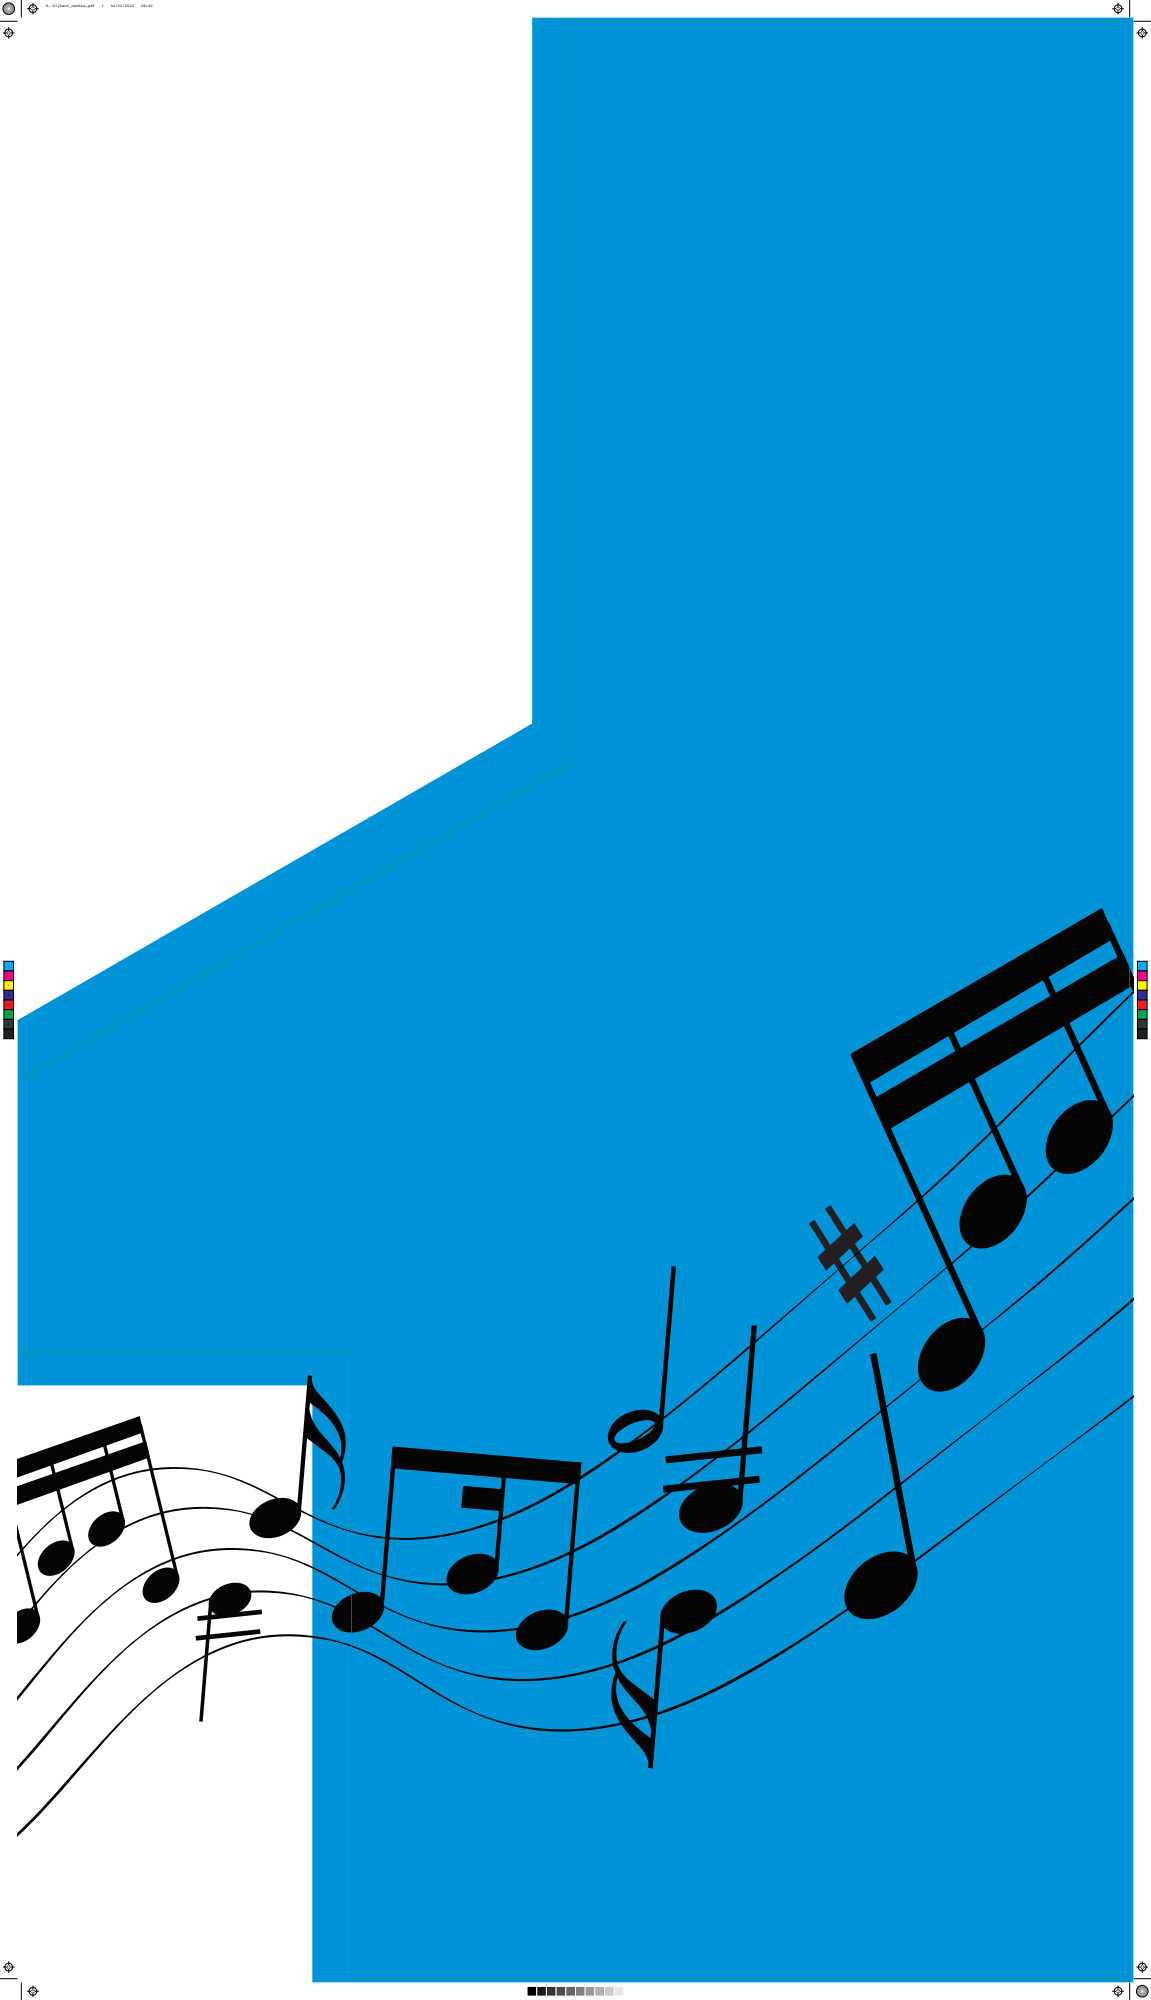
[picture p29: page 1]
CMY; 8. Zijkant_rechts.pdf
