woutput/regenboogpiano/Elektronica/KiCad projecten/Moederbord/Moederbord.kicad_pcb

## KiCad design Elektronica/KiCad projecten/Moederbord/Moederbord.kicad_pcb (2022-01-05)

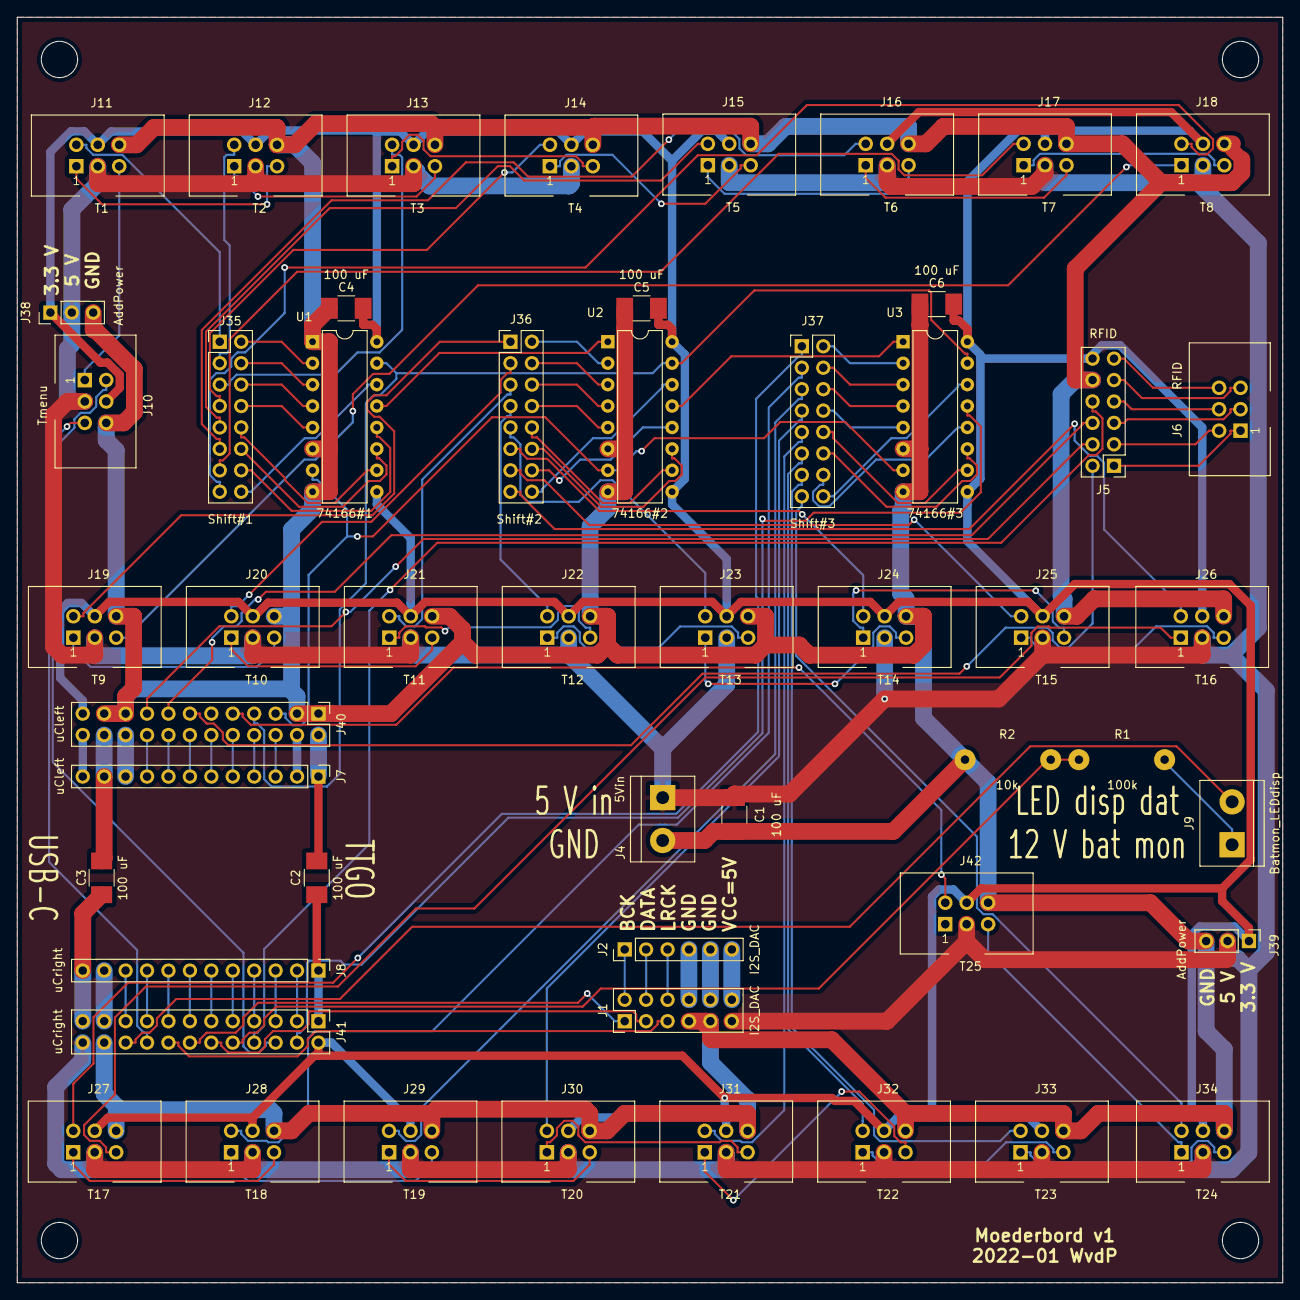
[picture p30: board Moederbord.kicad_pcb from above]

Board: 2 copper layers, 150.0 x 150.0 mm, 56 parts (0 on the bottom side), 130 nets.

Parts:
C1, C2, C3, C4, C5, C6: 100 uF; C_1210_HandSoldering
J1: I2S_DAC; Pin_Header_Straight_2x06_Pitch2.54mm
J2: I2S_DAC; Socket_Strip_Straight_1x06_Pitch2.54mm
J4: 5Vin; TerminalBlock_2_P5.08mm
J5: RFID; Pin_Header_Straight_2x06_Pitch2.54mm
J6: RFID; IDC_Header_Straight_6pins
J7: uCleft; Socket_Strip_Straight_1x12_Pitch2.54mm
J8: uCright; Socket_Strip_Straight_1x12_Pitch2.54mm
J9: Batmon_LEDdisp; TerminalBlock_2_P5.08mm
J10: Tmenu; IDC_Header_Straight_6pins
J11: T1; IDC_Header_Straight_6pins
J12: T2; IDC_Header_Straight_6pins
J13: T3; IDC_Header_Straight_6pins
J14: T4; IDC_Header_Straight_6pins
J15: T5; IDC_Header_Straight_6pins
J16: T6; IDC_Header_Straight_6pins
J17: T7; IDC_Header_Straight_6pins
J18: T8; IDC_Header_Straight_6pins
J19: T9; IDC_Header_Straight_6pins
J20: T10; IDC_Header_Straight_6pins
J21: T11; IDC_Header_Straight_6pins
J22: T12; IDC_Header_Straight_6pins
J23: T13; IDC_Header_Straight_6pins
J24: T14; IDC_Header_Straight_6pins
J25: T15; IDC_Header_Straight_6pins
J26: T16; IDC_Header_Straight_6pins
J27: T17; IDC_Header_Straight_6pins
J28: T18; IDC_Header_Straight_6pins
J29: T19; IDC_Header_Straight_6pins
J30: T20; IDC_Header_Straight_6pins
J31: T21; IDC_Header_Straight_6pins
J32: T22; IDC_Header_Straight_6pins
J33: T23; IDC_Header_Straight_6pins
J34: T24; IDC_Header_Straight_6pins
J35: Shift#1; Pin_Header_Straight_2x08_Pitch2.54mm
J36: Shift#2; Pin_Header_Straight_2x08_Pitch2.54mm
J37: Shift#3; Pin_Header_Straight_2x08_Pitch2.54mm
J38, J39: AddPower; Pin_Header_Straight_1x03_Pitch2.54mm
J40: uCleft; Pin_Header_Straight_2x12_Pitch2.54mm
J41: uCright; Pin_Header_Straight_2x12_Pitch2.54mm
J42: T25; IDC_Header_Straight_6pins
R1: 100k; WireConnection_1.00mmDrill
R2: 10k; WireConnection_1.00mmDrill
U1: 74166#1; DIP-16_W7.62mm
U2: 74166#2; DIP-16_W7.62mm
U3: 74166#3; DIP-16_W7.62mm
X1, X2, X3, X4: MountingHole_4.3mm_M4

Connections:
+3V3: C4.1, C5.1, C6.1, J5.12, J10.4, J11.4, J12.4, J13.4, J14.4, J15.4, J16.4, J17.4, J18.4, J19.4, J20.4, J21.4, J22.4, J23.4, J24.4, J25.4, J26.4, J27.4, J28.4, J29.4, J30.4, J31.4, J32.4, J33.4, J34.4, J38.1, J39.1, J40.23, J41.2, J42.4, U1.9, U1.16, U2.9, U2.16, U3.9, U3.16
+5V: C1.2, J1.11, J4.1, J10.3, J11.3, J12.3, J13.3, J14.3, J15.3, J16.3, J17.3, J18.3, J19.3, J20.3, J21.3, J22.3, J23.3, J24.3, J25.3, J26.3, J27.3, J28.3, J29.3, J30.3, J31.3, J32.3, J33.3, J34.3, J38.2, J39.2, J41.24, J42.3
/Shift registers/T1: J35.2, U1.2
/Shift registers/T2: J35.4, U1.3
/Shift registers/T3: J35.6, U1.4
/Shift registers/T4: J35.8, U1.5
/Shift registers/T5: J35.10, U1.10
/Shift registers/T6: J35.12, U1.11
/Shift registers/T7: J35.14, U1.12
/Shift registers/T8: J35.16, U1.14
/Shift registers/T9: J36.2, U2.2
/Shift registers/T10: J36.4, U2.3
/Shift registers/T11: J36.6, U2.4
/Shift registers/T12: J36.8, U2.5
/Shift registers/T13: J36.10, U2.10
/Shift registers/T14: J36.12, U2.11
/Shift registers/T15: J36.14, U2.12
/Shift registers/T16: J36.16, U2.14
/Shift registers/T17: J37.2, U3.2
/Shift registers/T18: J37.4, U3.3
/Shift registers/T19: J37.6, U3.4
/Shift registers/T20: J37.8, U3.5
/Shift registers/T21: J37.10, U3.10
/Shift registers/T22: J37.12, U3.11
/Shift registers/T23: J37.14, U3.12
/Shift registers/T24: J37.16, U3.14
/Shift registers/s1_s2: U1.13, U2.1
/Shift registers/s2_s3: U2.13, U3.1
/Toetsmodules/LED1_LED2: J11.1, J12.5
/Toetsmodules/LED2_LED3: J12.1, J13.5
/Toetsmodules/LED3_LED4: J13.1, J14.5
/Toetsmodules/LED4_LED5: J14.1, J15.5
/Toetsmodules/LED5_LED6: J15.1, J16.5
/Toetsmodules/LED6_LED7: J16.1, J17.5
/Toetsmodules/LED7_LED8: J17.1, J18.5
/Toetsmodules/LED8_LED9: J18.1, J19.5
/Toetsmodules/LED9_LED10: J19.1, J20.5
/Toetsmodules/LED10_LED11: J20.1, J21.5
/Toetsmodules/LED11_LED12: J21.1, J22.5
/Toetsmodules/LED12_LED13: J22.1, J23.5
/Toetsmodules/LED13_LED14: J23.1, J24.5
/Toetsmodules/LED14_LED15: J24.1, J25.5
/Toetsmodules/LED15_LED16: J25.1, J26.5
/Toetsmodules/LED16_LED17: J26.1, J27.5
/Toetsmodules/LED17_LED18: J27.1, J28.5
/Toetsmodules/LED18_LED19: J28.1, J29.5
/Toetsmodules/LED19_LED20: J29.1, J30.5
/Toetsmodules/LED20_LED21: J30.1, J31.5
/Toetsmodules/LED21_LED22: J31.1, J32.5
/Toetsmodules/LED22_LED23: J32.1, J33.5
/Toetsmodules/LED23_LED24: J33.1, J34.5
/Toetsmodules/LED24_LED25: J34.1, J42.5
/Toetsmodules/LEDm_LED1: J10.1, J11.5
/Vbat12V: J9.1, R1.1
BatMon: J41.10, R1.2, R2.1
DAC_BCK: J1.1, J41.14
DAC_DATA: J1.3, J41.12
DAC_LRCK: J1.5, J41.16
GND: C1.1, C4.2, C5.2, C6.2, J1.7, J1.9, J4.2, J5.10, J10.6, J11.6, J12.6, J13.6, J14.6, J15.6, J16.6, J17.6, J18.6, J19.6, J20.6, J21.6, J22.6, J23.6, J24.6, J25.6, J26.6, J27.6, J28.6, J29.6, J30.6, J31.6, J32.6, J33.6, J34.6, J38.3, J39.3, J40.1, J40.3, J40.19, J40.21, J41.22, J42.6, R2.2, U1.1, U1.6, U1.8, U2.6, U2.8, U3.6, U3.8
LED_display_data: J9.2, J41.20
LED_rings_data: J10.5, J41.18
unnamed: C2.1, J8.1, J41.1
unnamed: C2.2, J7.1, J40.2
unnamed: C3.1, J8.12, J41.23
unnamed: C3.2, J7.11, J40.22
unnamed: J1.2, J2.1
unnamed: J1.4, J2.2
unnamed: J1.6, J2.3
unnamed: J1.8, J2.4
unnamed: J1.10, J2.5
unnamed: J1.12, J2.6
unnamed: J5.1, J6.1
unnamed: J5.3, J6.2
unnamed: J5.5, J6.3
unnamed: J5.7, J6.4
unnamed: J5.9, J6.5
unnamed: J5.11, J6.6
unnamed: J7.2, J40.4
unnamed: J7.3, J40.6
unnamed: J7.4, J40.8
unnamed: J7.5, J40.10
unnamed: J7.6, J40.12
unnamed: J7.7, J40.14
unnamed: J7.8, J40.16
unnamed: J7.9, J40.18
unnamed: J7.10, J40.20
unnamed: J7.12, J40.24
unnamed: J8.2, J41.3
unnamed: J8.3, J41.5
unnamed: J8.4, J41.7
unnamed: J8.5, J41.9
unnamed: J8.6, J41.11
unnamed: J8.7, J41.13
unnamed: J8.8, J41.15
unnamed: J8.9, J41.17
unnamed: J8.10, J41.19
unnamed: J8.11, J41.21
RFID_CS: J5.2, J40.13
RFID_MISO: J5.8, J41.8
RFID_MOSI: J5.6, J40.15
RFID_SCLK: J5.4, J40.17
Shift_CLK: J40.5, U1.7, U2.7, U3.7
Shift_SH_LDn: J40.7, U1.15, U2.15, U3.15
Shift_data: J41.4, U3.13
Touch1: J11.2, J35.1
Touch2: J12.2, J35.3
Touch3: J13.2, J35.5
Touch4: J14.2, J35.7
Touch5: J15.2, J35.9
Touch6: J16.2, J35.11
Touch7: J17.2, J35.13
Touch8: J18.2, J35.15
Touch9: J19.2, J36.1
Touch10: J20.2, J36.3
Touch11: J21.2, J36.5
Touch12: J22.2, J36.7
Touch13: J23.2, J36.9
Touch14: J24.2, J36.11
Touch15: J25.2, J36.13
Touch16: J26.2, J36.15
Touch17: J27.2, J37.1
Touch18: J28.2, J37.3
Touch19: J29.2, J37.5
Touch20: J30.2, J37.7
Touch21: J31.2, J37.9
Touch22: J32.2, J37.11
Touch23: J33.2, J37.13
Touch24: J34.2, J37.15
Touch25: J40.9, J42.2
Touch_menu: J10.2, J41.6
