woutput/regenboogpiano/Elektronica/KiCad projecten/Toetsmodule/Toetsmodule.kicad_pcb

## KiCad design Elektronica/KiCad projecten/Toetsmodule/Toetsmodule.kicad_pcb (2021-12-19)

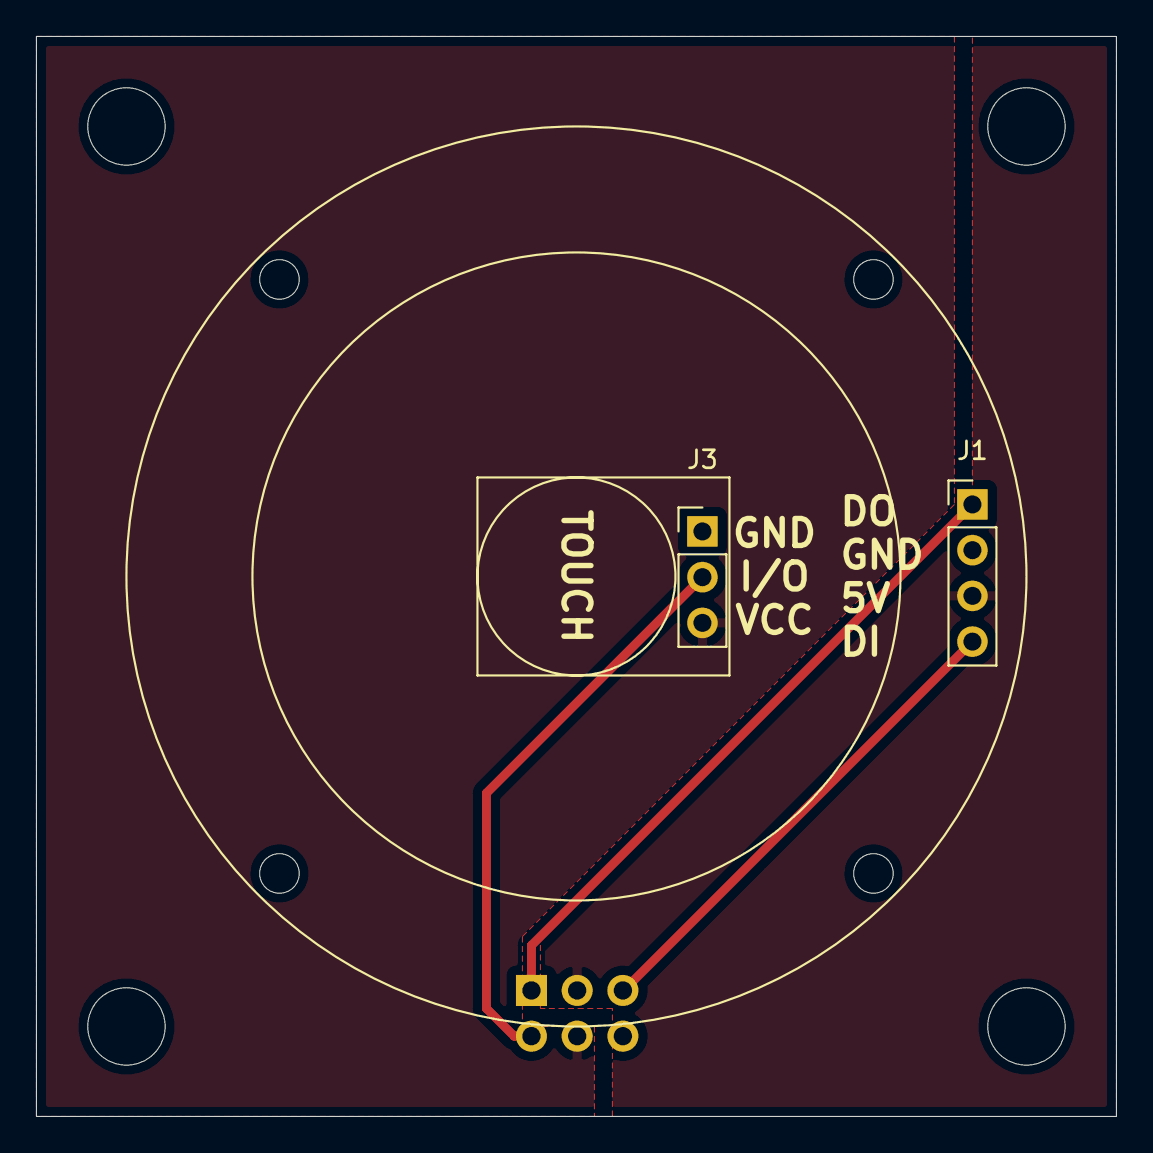
[picture p31: board Toetsmodule.kicad_pcb from above]

Board: 2 copper layers, 60.0 x 60.0 mm, 3 parts (1 on the bottom side), 6 nets.

Parts:
J1: Conn_01x04_Male; Pin_Header_Straight_1x04_Pitch2.54mm
J2: Conn_01x06_Male; IDC_Header_Straight_6pins
J3: Touch module; Pin_Header_Straight_1x03_Pitch2.54mm

Connections:
+3V3: J2.4, J3.3
+5V: J1.3, J2.3
/LED_in: J1.4, J2.5
/LED_out: J1.1, J2.1
/Touch_output: J2.2, J3.2
GND: J1.2, J2.6, J3.1
