woutput/regenboogpiano/(commit log)

2021-11-30 Eerste versie
    [14 Kleuren.xlsm, Afmetingen kinderen.xlsx, Custom PCB kosten.xlsx, Elektronisch wandspeelbord - onderdelen.xlsx, Kunststof.xlsx, Moederbord.kicad_pcb, Moederbord.sch, Onderdelen en kosten.xlsx]
2021-11-30 Dingen naar map oud
    [Afmetingen kinderen.xlsx, Elektronisch wandspeelbord - onderdelen.xlsx, Kunststof.xlsx]
2021-11-30 Update Sketchup-model
    [Regenboogpiano.skp]
2021-11-30 Verplaatsen naar mappen
    [Regenboogpiano.skp, piano.skp, piano1.skp]
2021-11-30 Update 3D-model
    [Regenboogpiano.skp]
2021-11-30 Update bestellingen
    [Onderdelen en kosten.xlsx]
2021-12-01 Update moederbord schema
    [Moederbord.sch]
2021-12-03 Update schema moederbord
    [Moederbord.sch]
2021-12-06 Eerste toewijzingen van controller-pinnen
    [Controller pin-toewijzingen.xlsx]
2021-12-06 Added micro SD card support
    [Controller pin-toewijzingen.xlsx]
2021-12-08 Update software en pin-toewijzingen
    [Controller pin-toewijzingen.xlsx]
2021-12-08 Definitie spellen
    [Spellen.xlsx]
2021-12-09 Update na overleg
    [Controller pin-toewijzingen.xlsx, Keuzes.xlsx, Moederbord.kicad_pcb, Moederbord.sch, Shift_registers.sch, Taken.xlsx, Toetsmodule.kicad_pcb, Toetsmodules.sch]
2021-12-10 Software update
    [Controller pin-toewijzingen.xlsx, Keuzes.xlsx]
2021-12-14 Update toetsmodule: 60 x 60 mm & M4 gaten
    [Toetsmodule.kicad_pcb]
2021-12-14 Update moederbord
    [Controller pin-toewijzingen.xlsx, Moederbord.kicad_pcb, Moederbord.sch, Shift_registers.sch, Toetsmodules.sch]
2021-12-18 Update voor shift registers
    [Toetsmodule.sch, Toetsmodules.sch]
2021-12-18 Bestanden ordenen in mappen
    [14 Kleuren.xlsm, Controller pin-toewijzingen.xlsx, Custom PCB kosten.xlsx, Moederbord.kicad_pcb, Moederbord.sch, Regenboogpiano.skp, Shift_registers.sch, Spellen.xlsx]
2021-12-19 Toetsmodule v1 klaar
    [Toetsmodule.kicad_pcb, Toetsmodule.sch]
2021-12-26 Datasheets + update moederbord
    [Moederbord.kicad_pcb, Moederbord.sch, Toetsmodules.sch]
2021-12-28 Update vanwege 25e toets (dus nu 26 toetsmodules met menu-knop)
    [Controller pin-toewijzingen.xlsx, Moederbord.kicad_pcb, Moederbord.sch, Shift_registers.sch, Toetsmodules.sch]
2022-01-05 Eerste versie van moederbord klaar
    [Moederbord.kicad_pcb, Moederbord.sch]
2022-01-12 Klavier toegevoegd
    [Klavier.skp]
2022-02-05 Update software
    [Kabellengtes moederbord-toetsmodules.xlsx]
2022-02-06 Software update, now with MP3s from SPIFFS
    [default_16MB.csv]
2022-02-08 Nieuwe MP3s, nieuwe software en facturen
    [Onderdelen en kosten.xlsx]
2022-03-08 Werkend beginpunt
    [Kabellengtes moederbord-toetsmodules.xlsx]
2022-03-10 Nieuwe factuur en software update
    [Onderdelen en kosten.xlsx]
